zhutao198/SMU/产品需求文档PRD.md

# SMU 源表产品需求文档（PRD）

| 项 | 内容 |
|---|---|
| 产品名称 | SMU 源表（Source-Measure Unit） |
| 硬件版本 | V1（PCB `Source-measure unit -V1-240824`，BOM `BOM-SMU-V1-240904`） |
| 文档版本 | **V1.2**（V1.1 新增 Web 设置/实时显示；V1.2 记录 M1 固件框架完成及两处实现微调） |
| 日期 | 2026-10-20 |
| 状态 | M1 已实现，待评审/上电验证 |
| 依据 | 《硬件原理分析与固件设计.md》（已用 PADS 网表逐网核实）、《code/firmware/README.md》 |

---

## 1. 项目背景与目标

### 1.1 背景
硬件已完成原理图与 PCB 设计，尚未编写固件。本 PRD 在固件开发前明确产品功能、性能、接口与验收标准，作为编码与测试的唯一基准。

### 1.2 产品目标
做一台**单象限、低电流、数控电压源 + 电压/电流测量**的紧凑型源表：
- 输出 **0~30V / 0~30mA** 可编程电压或电流（CV / CC）；
- 可切换为**外部 DUT 的电压表 / 电流表**（高阻测量）；
- 通过 **USB 串口（CH340N）** 由 PC 上位机/脚本控制，无本地显示与按键；
- **内置 Web 服务器（LAN8720 以太网）**：浏览器直接访问仪器 IP 即可设置输出、实时显示测量数据与状态曲线——**网页即人机界面**，无需安装 PC 软件；
- 保留原始 TCP 命令通道作为可选调试接口。

### 1.3 非目标（明确不做）
- 负电压/负电流输出（硬件单象限，软件无法弥补）；
- 大电流（>50mA）输出——受 P2 自恢复保险丝（0.2A）与测量量程限制；
- 4 线（Kelvin）传感——本硬件为 2 线制；
- 本地人机界面（屏/按键/编码器）——硬件未提供。

---

## 2. 使用场景与用户

| 场景 | 模式 | 说明 |
|---|---|---|
| 可调电压源 | CV | 给 DUT 供 0~30V 稳定电压，带限流保护 |
| 可调电流源 | CC | 给 DUT 供 0~30mA 稳定电流（ compliance ≤30V ） |
| 电压表 | VM | 高阻测外部电压（负载 ≈96.6kΩ） |
| 电流表 | IM | 测外部灌入电流（−32mA~+32mA），内部经 Q5 接地 |
| 器件特性扫描 | CV/CC + 测量 | 扫描设定值、连续读回 V/I（软件功能） |
| 远程监控/手动操作 | Web | 任意浏览器访问仪器 IP：设置输出、看实时数据与曲线，无需 PC 软件 |

**目标用户**：实验室/产线工程师，通过 PC 上位机（后续提供）或自编脚本控制。

---

## 3. 硬件约束摘要（固件必须遵守）

| 项 | 值 | 出处 |
|---|---|---|
| MCU | STM32F407VET6，168MHz，512KB Flash | BOM |
| 输出母线 | +35V（由 +5V 经 LMR64010 升压） | 原理图 P2 |
| 功率级 | LM5106 驱动 Q3/Q4 同步降压，L3=10µH，C117/C118=10µF | 原理图 P4 |
| 占空比→电压 | **V_BUCK ≈ D × 35V** | 拓扑推算 |
| 输出开关 | Q1/Q2 串联，I_V_TEST_EN 通断（R25/D4/Q6） | 网表核实 |
| 输出保护 | P2 自恢复保险丝 0.2A（保持）/0.4A（动作） | BOM |
| 电流采样 | R133 = 1Ω，INA129 ×51，REF = 1.65V | 网表核实 |
| 电压采样 | R137 86.6k / R157 10k（÷9.66），TLV2333 缓冲 | 网表核实 |
| ADC | ADS1115，I2C 地址 0x48，16bit，PGA=±4.096V → **125µV/LSB** | 网表核实 |
| 控制脚 | VOUT_PWM=PB3(TIM2_CH2)、VOUT_EN=PB4、I_TEST_EN=PD1、I_V_TEST_EN=PD2、RDY_1=PB5、SCL=PB6、SDA=PB7 | 网表核实 |
| 输出端子 | J4：pin2=I_V_OUT，pin1=GND（2 线） | 网表核实 |
| 以太网 | LAN8720（RMII，25M 晶振，PHY 输出 50MHz → PA1；NRST 由 R4 上拉，无 GPIO 复位；PHY 地址按默认 0） | 网表核实 |
| 上位机接口 | USART1（PA9/PA10）→ CH340N → Type-C USB；以太网（Web 服务器） | 网表核实 |
| Flash 预算 | 512KB 总容量；Web 页面资源内嵌（板无外部存储），预算 **≤64KB** | 硬件推导 |
| 配置开关 | J18 两位拨码 → PC11/PC12（内部上拉，0=闭合） | 网表核实 |
| 电源链 | 9~24V → +5V → +35V → +11V；+3.3V/3.3VA；−0.23V | 网表核实 |

**已知硬件限制（影响指标，PRD 中已体现）**：
1. 电流测量量程受 VREF=1.65V 偏置影响：ADC 输入 0~3.3V 窗口 → 约 **−32mA ~ +32mA**；
2. INA129 由 +35V 供电，输出摆幅大，过流时会顶到 ADC 保护二极管（>3.3V 按饱和处理）；
3. 无 EEPROM，标定系数需自管 Flash 页；
4. Type-C 无 CC 下拉，仅 A-to-C 线可用；
5. +35V 依赖 +5V 先生成；
6. 无本地显示/LED（D10 为硬件电源指示），状态只能经通信口查询。

---

## 4. 功能需求

### 4.1 工作模式（FR-MODE）

| ID | 需求 | 验收要点 |
|---|---|---|
| FR-MODE-1 | **高阻模式（HIZ）**：输出端子与内部功率级断开，对外等效约 96.6kΩ∥(INA 输入) | 端子电压不随内部状态变化；静态电流 <10µA |
| FR-MODE-2 | **恒压输出（CV）**：闭环调节 PWM 占空比，使端子电压 = 设定值 | 见 §5 精度指标 |
| FR-MODE-3 | **恒流输出（CC）**：闭环调节占空比，使回路电流 = 设定值，电压不超过限值 | compliance ≤30V |
| FR-MODE-4 | **电压测量（VM）**：输出断开，测 DUT 端压 | 量程/分辨率见 §5 |
| FR-MODE-5 | **电流测量（IM）**：输出断开，Q5 导通将 DUT 电流引入采样电阻 | 双向，软件判符号 |
| FR-MODE-6 | 模式切换必须按安全时序执行，禁止带电直接切换（见 FR-SAFE-3） | 模式切换无输出冲击（示波器监视 <50mV 反冲） |
| FR-MODE-7 | 模式状态持久：掉电后重新上电默认进入 HIZ | 任何掉电重启均不直接输出 |

### 4.2 输出控制（FR-OUT）

| ID | 需求 |
|---|---|
| FR-OUT-1 | 电压设定范围 0~30.0V，最小设定步进 1mV，分辨率 1mV |
| FR-OUT-2 | 电流设定范围 0~30.0mA，最小设定步进 0.01mA，分辨率 10µA |
| FR-OUT-3 | CV 模式下限流：回路电流超过 `CURR` 设定值时自动进入限流（不损坏硬件，指标降级允许） |
| FR-OUT-4 | CC 模式限压：端子电压超过 `VOLT:PROT` 设定值时立即关断输出并置保护标志 |
| FR-OUT-5 | 输出软启动：从 0 到设定值的建立过程单调、无过冲 >2%，建立时间 <500ms（0→30V 阶跃） |
| FR-OUT-6 | 设定值在输出中可实时修改，修改后 200ms 内收敛到新值 ±1% |

### 4.3 测量（FR-MEAS）

| ID | 需求 |
|---|---|
| FR-MEAS-1 | 电压测量量程 0~30V，分辨率 1.2mV，刷新率 ≥100 次/s |
| FR-MEAS-2 | 电流测量量程 −32mA~+32mA，分辨率 2.5µA，刷新率 ≥100 次/s |
| FR-MEAS-3 | 采样由 ADS1115 的 ALERT/RDY（→PB5）中断驱动，禁止固定延时轮询 |
| FR-MEAS-4 | 软件数字滤波（滑动平均/中值，窗口可配置，默认 8 点），滤除 PWM 斩波纹波 |
| FR-MEAS-5 | 原始 ADC 码值、工程量、滤波后工程量均可查询（调试用） |
| FR-MEAS-6 | 标定：电压/电流各支持两点（零点+增益）标定，系数存 Flash，支持恢复出厂默认 |

### 4.4 通信接口（FR-COMM）

| ID | 需求 |
|---|---|
| FR-COMM-1 | USART1：115200-8N1，ASCII 命令，LF 结尾，单行单命令；命令回显错误信息 |
| FR-COMM-2 | SCPI 风格命令子集（§6），查询以 `?` 结尾，响应一行 ASCII |
| FR-COMM-3 | 通信看门狗：输出模式下 5s 无有效命令 → 按配置（默认保持，可配关断）处理 |
| FR-COMM-4 | 错误队列：错误码 + 文本，支持 `SYST:ERR?` 读取与清除 |
| FR-COMM-5 | ~~二期~~：以太网**原始 TCP 命令通道**（端口 5025）降级为**可选调试接口**，命令层复用 §6.2，不阻塞 V1.0 验收（Web 通道见 §4.6） |
| FR-COMM-6 | J18 拨码状态可查询；其功能用途预留（建议：bit0=默认 CV/CC 上电模式，bit1=保留），最终定义见评审结论 |

### 4.5 自检与诊断（FR-DIAG）

| ID | 需求 |
|---|---|
| FR-DIAG-1 | 上电自检：I2C 总线扫描（ADS1115 @0x48 必须在线）、ADC 读写校验、Flash 标定区 CRC 校验 |
| FR-DIAG-2 | 自检失败 → 进入 HIZ 并上报错误码，禁止输出 |
| FR-DIAG-3 | 运行中 ADC 通信失败/数据异常（连续 N 次超范围）→ 关断输出并置错误 |
| FR-DIAG-4 | MCU 片内温度传感器周期读取，可用于过温预警（非精确保护） |
| FR-DIAG-5 | `STAT?` 返回状态字：模式 / 就绪 / 保护触发 / ADC 在线 / 错误码 |

### 4.6 Web 界面（FR-WEB）★本次新增

> 定位：**网页即人机界面**。仪器接入以太网后，任意浏览器（PC/手机）打开仪器 IP 即可完成全部设置与监控，
> 不需要安装 PC 端软件。Web 与串口共用同一命令层与状态机，**不是旁路**。

| ID | 需求 | 验收要点 |
|---|---|---|
| FR-WEB-1 | 以太网基础：LAN8720 RMII，**FreeRTOS + LwIP**；上电自动初始化；IP 获取 **DHCP 优先，失败回退静态 192.168.1.10/24**（可改，存 Flash）；当前 IP 在上电时经串口打印、并在页面显示 | 网线插入后 PC 能 ping 通仪器 |
| FR-WEB-2 | HTTP 服务：端口 80；页面资源（HTML/CSS/JS）**内嵌于固件 Flash**（LwIP `fs`，构建脚本由源码生成 C 数组），禁止依赖外部文件系统；单页应用，总资源 **≤64KB** | 构建时检查大小；无外挂 CDN/字体/图片请求 |
| FR-WEB-3 | 页面显示（中文 UI，UTF-8，响应式可窄栏）：当前模式、V/I 设定值、**V/I 实时测量值**、保护阈值、状态字与错误信息、J18 拨码状态、固件版本、仪器 IP 与 MAC | 数据与串口 `MEAS:ALL?`/`STAT?` 一致 |
| FR-WEB-4 | 页面操作：模式切换（CV/CC/VM/IM/HIZ）、电压/电流设定、保护阈值设置、OUTP ON/OFF、`*RST`/`*CLS`；参数范围校验与串口完全一致，非法输入返回错误提示 | 所有操作与串口等效 |
| FR-WEB-5 | **实时刷新**：测量数据 **≤500ms** 自动刷新、无整页重载（AJAX 轮询 `/data.json`，间隔 300ms）；页面带 **V/I 滚动曲线**（Canvas 手绘，本地 60 点缓冲，禁用第三方库） | 曲线连续无卡顿；刷新不影响控制环（见 AC-12） |
| FR-WEB-6 | 安全一致性：Web 命令与串口命令走**同一状态机**，§7 的 SR-1~SR-7 全部适用；Web 不能绕过任何保护与互锁；模式切换时序强制 | 通过网页触发保护，行为与串口一致 |
| FR-WEB-7 | 并发控制：串口与 Web 可同时在线；命令层串行化（命令队列），**后写覆盖**；两个通道不得并发发起模式切换（队列 + 状态机天然串行） | 双通道同时操作不死锁、不抖动 |
| FR-WEB-8 | 网络健壮性：网线热插拔、DHCP 租约更新、异常断开均不得影响控制环（tcpip/httpd 任务优先级**低于**控制任务）；同时活跃连接 ≤4 | 拔插网线时输出不中断（控制环照常） |
| FR-WEB-9 | V1.0 **无认证**（适用隔离实验网），风险登记 R-11；预留后续加 token 的结构 | 文档明示风险 |

---

## 5. 性能指标（PR）

> 受硬件 1% 采样电阻/分压电阻、INA129 增益误差、ADS1115 内部基准限制，**未标定前的典型精度约 ±2%**；
> 标定后目标如下（验收时以 4½ 位标准源表比对）。

| ID | 指标 | 目标值 | 备注 |
|---|---|---|---|
| PR-1 | 电压设定准确度（标定后） | ±(0.5% + 2mV) | 25℃ |
| PR-2 | 电压测量准确度（标定后） | ±(0.5% + 2mV) | 分压比 9.66 |
| PR-3 | 电流设定/测量准确度（标定后） | ±(1% + 10µA) | shunt 1% → 需标定补偿 |
| PR-4 | 电压分辨率 | 1.2mV | 125µV × 9.66 |
| PR-5 | 电流分辨率 | 2.5µA | 125µV / 51 |
| PR-6 | 输出建立时间 | <500ms（0→30V，空载） | 软启动 |
| PR-7 | 24h 稳定性 | 电压 <±10mV；电流 <±20µA | 25℃ 恒温 |
| PR-8 | 控制环更新率 | ≥100Hz | RDY 中断驱动，330SPS ADC |
| PR-9 | 上电到就绪时间 | <2s | 含自检 |
| PR-10 | 静态功耗（输出关断） | <1W | 整机 |

---

## 6. 通信协议需求（IR）

### 6.1 物理层
USART1 115200-8N1，无硬件流控。命令行以 LF（`\n`）结束，最长 64 字符；大小写不敏感；命令与参数间空格或逗号分隔。

### 6.2 命令集（V1.0 必须实现）

| 命令 | 类型 | 说明 / 响应示例 |
|---|---|---|
| `*IDN?` | 查询 | `SMU-V1, FW1.0.0, SN:xxxxxxxx` |
| `*RST` | 执行 | 复位到上电默认（HIZ、设定值 0、保护默认） |
| `*CLS` | 执行 | 清错误队列与保护标志 |
| `MODE?` | 查询 | `CV` / `CC` / `VM` / `IM` / `HIZ` |
| `MODE CV\|CC\|VM\|IM\|HIZ` | 执行 | 按安全时序切换，失败返回错误 |
| `VOLT?` / `VOLT <v>` | 查询/执行 | 电压设定值，单位 V，范围 0~30 |
| `CURR?` / `CURR <i>` | 查询/执行 | 电流设定值，单位 mA，范围 0~30 |
| `VOLT:PROT?` / `VOLT:PROT <v>` | 查询/执行 | 过压保护阈值，默认 30V |
| `CURR:PROT?` / `CURR:PROT <i>` | 查询/执行 | 过流保护阈值，默认 30mA |
| `OUTP ON\|OFF` | 执行 | ON = 进入当前设定模式输出；OFF = HIZ |
| `MEAS:VOLT?` | 查询 | 端子电压工程量，如 `12.3456`（V） |
| `MEAS:CURR?` | 查询 | 回路电流工程量，如 `10.1234`（mA） |
| `MEAS:ALL?` | 查询 | `V=12.3456,I=10.1234` |
| `STAT?` | 查询 | 状态字（位域，见下），如 `13` |
| `SYST:ERR?` | 查询 | 错误码 + 文本；队列空返回 `0,"No error"` |
| `SYST:VERS?` | 查询 | 固件版本 |
| `CAL:VOLT:ZERO` / `CAL:VOLT:GAIN <v>` | 执行 | 两点标定（外部标准源接入时执行） |
| `CAL:CURR:ZERO` / `CAL:CURR:GAIN <i>` | 执行 | 同上 |
| `CAL:SAVE` / `CAL:DEF` | 执行 | 保存系数到 Flash / 恢复默认 |
| `J18?` | 查询 | `0`/`1`/`2`/`3`（两位拨码） |
| `RAW?` | 查询 | 原始 ADC 码值（调试）：`AIN0=xxxx,AIN1=xxxx,AIN2=xxxx,AIN3=xxxx` |

错误响应格式：`-100,"Command error"`（SCPI 风格负错误码）。

**状态字（`STAT?` / `stat` 字段）位域定义**（Web 页面与串口共用）：

| bit | 值 | 含义 |
|---|---|---|
| 0 | 1 | READY 就绪（自检通过） |
| 1 | 2 | PROT 保护锁存（过压/过流/ADC 失效，需 `*CLS` 解除） |
| 2 | 4 | ADC_OK ADS1115 在线 |
| 3 | 8 | OUT_ACTIVE 输出已建立 |

示例：`13` = READY + ADC_OK + OUT_ACTIVE。

### 6.3 Web 接口规格（V1.0 范围，FR-WEB）

所有端点返回 UTF-8 文本/JSON；`/set` 参数校验、量程、保护规则与 §6.2 串口命令完全一致。

| 端点 | 方法 | 说明 |
|---|---|---|
| `/` | GET | 单页应用（HTML+CSS+JS 全部内嵌，见 FR-WEB-2） |
| `/data.json` | GET | 实时数据快照，示例：<br>`{"mode":"CV","vset":12.0,"iset":10.0,"vmeas":12.003,"imeas":9.998,"vprot":30,"iprot":30,"outp":1,"stat":13,"err":0,"j18":0,"fw":"1.0.0","ip":"192.168.1.10","mac":"00:80:e1:12:34:56"}` |
| `/set` | GET/POST | 表单参数：`mode=CV\|CC\|VM\|IM\|HIZ`、`volt=<0~30>`、`curr=<0~30>`、`vprot=<5~30>`、`iprot=<1~30>`、`outp=0\|1`；成功返回 `OK`，失败返回 `-1xx,"错误描述"` |
| `/cmd` | POST | 透传一条 §6.2 串口命令（调试用，如 `*IDN?`），响应同串口 |

- 刷新策略：页面每 **300ms** 轮询 `/data.json`；曲线数据用页面本地缓冲（60 点 ≈ 18s 窗口），不占用仪器存储。
- 静态资源策略：全部内嵌，无 Cookie、无外部依赖；页面在 Chrome/Edge/Firefox 当前两个大版本实测通过。
- 原始 TCP SCPI 通道（端口 5025）：**可选**，不阻塞 V1.0 验收。
- **原型已就绪**：`code/web/src/index.html`（19.3KB，单文件、零外部依赖）。浏览器直接打开即可评审；
  后端不可达时自动进入"演示模式"（本地仿真 CV/CC/VM/IM/HIZ、保护锁存、`*CLS`/`*RST`），
  固件接线后页面自动切换为真实端点，**无需任何改动**。

---

## 7. 安全与保护需求（SR）

| ID | 需求 | 实现要点 |
|---|---|---|
| SR-1 | **上电安全态**：任何复位/异常路径下默认 HIZ，输出只在收到明确命令后建立 | 初始化序列末尾才允许 `OUTP ON` |
| SR-2 | **过压保护**：`VOLT:PROT` 阈值（默认 30V）触发 → 100ms 内关断（VOUT_EN=0 + I_V_TEST_EN=1 + 占空比清 0），锁存，需 `*CLS` 或 `*RST` 解除 | 母线 35V，留 5V 裕量 |
| SR-3 | **过流保护**：`CURR:PROT` 阈值（默认 30mA）触发 → 同上；P2 保险丝（0.4A 动作）为最后硬件兜底 | 触发后报告 `ERR 1201` |
| SR-4 | **模式切换互锁**：输出模式↔测量模式必须先 HIZ 过渡（先 VOUT_EN=0 → 20ms → I_V_TEST_EN=1 → 按需 I_TEST_EN），禁止 I_V_TEST_EN 与 VOUT_EN 同时为有效输出组合 | 状态机强制 |
| SR-5 | **ADC 失效保护**：I2C 超时/数据异常 → 关断输出，锁存 | FR-DIAG-3 |
| SR-6 | **看门狗**：IWDG 100ms，喂狗失败自动复位（复位后仍为 HIZ） | 防飞控 |
| SR-7 | **反接/过流硬件**：输入端 D1（SS34）+ 输出端 P2 保险丝为硬件级，软件只做状态记录，不做依赖 | — |

---

## 8. 非功能需求（NFR）

| ID | 需求 |
|---|---|
| NFR-1 | **可标定性**：所有模拟链路系数（分压比、INA 增益、VREF、ADC 基准）以浮点系数集中管理，支持在线标定与 Flash 持久化 |
| NFR-2 | **Flash 磨损**：标定区采用双备份 + CRC + 写入计数，寿命 ≥10 万次保存；运行中禁止频繁写 Flash |
| NFR-3 | **可测试性**：提供 `RAW?`、`STAT?`、`SYST:ERR?`；关键中间量（占空比、滤波值、误差积分项）可在调试编译期打开 |
| NFR-4 | **代码结构**：**FreeRTOS + LwIP（netconn API）**；驱动（GPIO/PWM/I2C/ADS1115/Ethernet）与应用（模式状态机/控制环/命令层/Web）分层；HAL/LL；应用层禁止直接操作寄存器 |
| NFR-5 | **可维护性**：每处硬件假设（量程、引脚、时序）在代码中以宏/注释引用本文档章节号 |
| NFR-6 | **开发环境**：STM32CubeMX + HAL（或 LL）+ FreeRTOS + LwIP，Keil/IAR/GCC 任一；固件版本号统一在 `version.h` |
| NFR-7 | **文档**：随代码提交《固件设计说明》与《标定操作指南》，与本文档需求 ID 对应 |
| NFR-8 | **Web 资源构建**：页面源码独立存放（`code/web/src`），由构建脚本转为 C 数组（`fsdata.c`）随固件编译；总大小 ≤64KB（FR-WEB-2），超限构建失败 |

---

## 9. 验收标准（AC）

| ID | 验收项 | 方法 | 通过标准 |
|---|---|---|---|
| AC-1 | 模式全覆盖 | 串口命令遍历 5 种模式，万用表/示波器监视端子 | 5 模式行为符合 §4.1，切换无反冲 |
| AC-2 | CV 精度 | 0/5/10/15/20/25/30V 六点，标准源表比对 | 满足 PR-1 |
| AC-3 | CC 精度 | 1/5/10/20/30mA 五点（电阻负载） | 满足 PR-3 |
| AC-4 | VM/IM 精度 | 外部标准源输出 0~30V / 0~30mA，本机测量 | 满足 PR-2/PR-3 |
| AC-5 | 建立时间 | 0→30V 阶跃，示波器 | <500ms，过冲 <2% |
| AC-6 | 保护功能 | 分别触发过压/过流/ADC 失效/看门狗 | 100ms 内安全关断，状态可读，可恢复 |
| AC-7 | 通信健壮性 | 错误命令/超时/乱序/大小写 | 有错误响应，不死机；看门狗按配置动作 |
| AC-8 | 掉电重启 | 反复上电 50 次 | 每次均 HIZ 起步，无意外输出 |
| AC-9 | 老化 | 输出模式连续运行 72h | 无死机、无保护误触发，PR-7 漂移达标 |
| AC-10 | 标定流程 | 按《标定操作指南》执行两点标定 | 标定后达到 PR-1~PR-3；`CAL:DEF` 可回退 |
| AC-11 | **Web 功能** | 浏览器访问仪器 IP：读实时数据与曲线、改设定值、切模式、触发保护 | 数据 ≤500ms 刷新；操作与串口等效；SR-1~7 在 Web 路径全部生效 |
| AC-12 | **网络压力** | Web 连续轮询（300ms）同时运行 CV/CC 控制环 | 控制环频率下降 <10%；无死机、无丢命令 |
| AC-13 | **网络插拔** | 输出运行中反复插拔网线 20 次 | 输出不中断、控制环不受影响；IP 变化后页面自动恢复 |

---

## 10. 约束与假设

1. PC 端专用软件/脚本不在本 PRD 范围（Web 页面已覆盖基本操作）；串口命令集仍作为脚本化/自动化接口保留。
2. 以太网为 V1.0 范围（Web 界面）；PHY 无 GPIO 复位依赖（硬件 R4 上拉），仅需软件初始化 LAN8720。
3. 标定需要外部标准源表，由使用方在产线/实验室完成；固件提供标定通道。
4. J18 的功能定义（§4.4 FR-COMM-6）需评审确认，未确认前仅实现状态读取。
5. PCB 上 J34（SWD）若未贴片，首次烧录需飞线或后焊；`code/` 首次下载方式需与硬件方确认。
6. 电流测量范围的不对称性（−32mA~+32mA）为硬件固有，不通过软件"修复"，仅在文档与页面中明示。
7. **Web 页面资源内嵌固件 Flash**（板无外部存储），页面须精简；源码与生成物分离管理（NFR-8）。
8. 仪器 IP 默认 DHCP，失败回退 192.168.1.10/24；PC 需与仪器同网段（直连或经交换机/路由器）。
9. LAN8720 的 PHY 地址按上电默认 **0** 实现（MDIO 可改），首次联网需实测确认；若非 0 需在驱动中配置（R-10）。
10. V1.0 Web **无认证**，仅适用隔离实验网；接入办公网前须评估（R-11）。
11. 以太网为附加通道：USB 串口始终可用，Web 故障不影响仪器基本功能（降级可用）。

---

## 11. 风险与开放问题

| ID | 风险/问题 | 影响 | 对策 |
|---|---|---|---|
| R-1 | 电流量程小且不对称 | 应用场景受限 | PRD 明确量程；需求侧确认是否满足用途 |
| R-2 | P2 保险丝动作后自恢复需数秒~数十秒 | CC 误触发后长时间不可用 | 保护阈值默认 30mA，远离 0.4A 动作点 |
| R-3 | INA129 由 +35V 供电，严重过流时输出可远超 ADC 量程 | ADC 输入经 1kΩ 限流，有击穿风险 | 软件判饱和（>3.3V）立即降占空比；阈值远低于动作点 |
| R-4 | 无 EEPROM | 标定系数掉电丢失风险 | NFR-2 双备份 + CRC；出厂前执行 `CAL:SAVE` |
| R-5 | 2 线测量，线阻引入误差 | 长线大电流时压降明显 | 30mA 下线阻影响小（<30mV@1Ω）；需精确场合建议缩短线长 |
| R-6 | Type-C 无 CC 下拉 | C-to-C 线不可用 | 随产品配 A-to-C 线；文档明示 |
| R-7 | +35V 依赖 +5V | 5V 故障时全链失效 | FR-DIAG-1 上电自检间接发现；SR-5 兜底 |
| R-8 | 无本地显示 | 调试与现场诊断不便 | 串口状态查询 + `RAW?`；**Web 页面即远程界面**；后续可评估无线透传模组（硬件改版） |
| R-9 | Web 资源超出 Flash 预算 | 页面过大固件放不下 | 单页 ≤64KB 硬约束（NFR-8）；构建脚本强制检查 |
| R-10 | LwIP+FreeRTOS 集成风险（RMII 时序/PHY 地址/DHCP 环境） | 以太网不通 | M1 先做 ping 通再谈页面；PHY 地址实测；静态 IP 回退 |
| R-11 | Web 无认证，实验网内任意主机可操作仪器 | 误操作/安全 | 文档明示；二期加 token；建议隔离网使用 |
| R-12 | 双通道（串口+Web）并发写 | 设定值抖动/竞态 | 命令层串行化 + 后写覆盖（FR-WEB-7） |
| O-1 | J18 用途未定义 | 功能缺口 | 评审定义 |
| O-2 | PWM 频率未定（建议 100~200kHz） | 影响纹波/EMC/环带宽 | 开发阶段实测确定，记录到固件设计说明 |
| O-3 | LAN8720 数据手册已不在 datasheet 目录，PHY 地址/寄存器细节待查 | MDIO 访问可能失败 | 以 CubeMX LAN8720 模板默认地址 0 实现；首次联网实测 PHY ID |

---

## 12. 里程碑建议

| 阶段 | 内容 | 出口准则 |
|---|---|---|
| M1 固件框架 ✅ | FreeRTOS + LwIP 骨架、时钟/GPIO/PWM/I2C/ADS1115 驱动、串口命令解析、5 模式状态机、上电自检、Web 服务雏形、一键构建脚本 | **已完成**：编译链接通过（Flash 113KB/512KB、RAM 71KB/128KB），命令层/模式机/Web 路由全部就位；待上电验证 |
| M2 闭环与保护 | CV/CC PI 控制整定、软启动、SR-1~SR-7 完善、数字滤波 | AC-1/5/6/8 通过 |
| M3 标定与优化 | 两点标定流程验证、Flash 存储、精度优化、片内温度监控 | AC-2/3/4/9/10 通过 |
| M4 Web 界面 | `/data.json` 实时接口、单页应用（设置 + 实时值 + 曲线）接线联调 | AC-11/12/13 通过 |
| M5 交付 | 固件设计说明、标定指南、版本封板 | AC 全项通过 |
| M6（可选） | 原始 TCP SCPI 通道（5025）、批量扫描、DHCP、Web 认证 | 另行评审 |

### 12.1 M1 实现微调（相对本文档 V1.1 的偏差，已实现）

1. **RTOS 用原生 FreeRTOS API**（非 CMSIS-RTOS2）：本机 FreeRTOS 中间件的 CMSIS-RTOS v1 包装不完整，
   原生 API 更可控；`main.c` 调 `vTaskStartScheduler()`。
2. **Web 用自研 netconn HTTP 服务**（非 LwIP httpd/fs）：`smu_web.c` 直管路由，页面以 C 数组内嵌
   （`smu_webpage.h` 由 `tools/web2c.py` 生成），避免 LwIP fsdata 版本差异；满足 FR-WEB-2/6/8。
3. **以太网收包为轮询**（`task_net` 5ms 调 `SMU_NetPoll`）：不依赖 ETH 中断时序，拔插网线不影响控制环（AC-13）。
4. **命令层单一入口**：Web `/set` 把参数合成为命令走 `SMU_CmdExecute`，与串口完全同路（FR-WEB-6/7）。

---

## 13. 需求追踪

| 需求域 | 对应硬件事实（出处） |
|---|---|
| FR-MODE / FR-OUT | 原理图 P4 模式真值表；LM5106 IN/EN；Q1/Q2/Q6 通断逻辑 |
| FR-MEAS | R133+INA129+R50（电流）；R137/R157/R166/U18-A+R53（电压）；ADS1115 通道分配（网表） |
| FR-COMM | CH340N(USART1 PA9/PA10) |
| FR-WEB | LAN8720 RMII（25M 晶振 → PA1 输出 50MHz、NRST 由 R4 硬件上拉）；MCU 512KB Flash（Web 资源内嵌 ≤64KB）；RMII 引脚 PC1/PA1/PA2/PA7/PC4/PC5/PB11/PB12/PB13 |
| FR-DIAG | ADS1115 ALERT/RDY→PB5；MCU 内部温度传感器 |
| SR | P1/P2 保险丝、D4 栅压钳位、D3 采样钳位、LM5106 EN |
| PR | 量化指标全部由 §3 硬件参数推导（9.66、51、125µV/LSB、35V 母线） |
