zhutao198/SMU/硬件原理分析与固件设计.md

# SMU 源表 — 硬件原理分析与固件设计指南

> 依据：`Source-measure unit -V1-240824.pdf`（5 页原理图）、`BOM-SMU-V1-240904.xls`、`datasheet/`，
> 并用 `Source-measure unit -V1-240824.txt`（PADS Logic V9.5 网表导出）对全部关键网络做了交叉核实。
> 解读时间：2026-10-17。本文档用于编码前的原理消化，固件设计以本文档为基准。

---

## 0. 一句话总结

**STM32F407VET6** 用 **PWM（TIM2_CH2）数控一个 35V 供电的同步降压电路**产生 0~30V 输出；
输出回路串 **1Ω 采样电阻 + INA129 仪表放大器（×51）**测电流，**86.6K/10K 分压 + TLV2333 缓冲**测电压，
两者统一送到 **ADS1115（16 位 I2C ADC）**；MCU 用 4 根 GPIO（VOUT_EN / I_V_TEST_EN / I_TEST_EN / RDY_1）
切换四种工作模式。**无显示屏、无按键**，人机接口是 **CH340N（USB-Type-C，USART1）** 和 **LAN8720 以太网**。

---

## 1. 系统组成总览

| 模块 | 器件 | 说明 |
|---|---|---|
| MCU | STM32F407VET6 (LQFP-100)，8MHz 晶振 | BOM 为 VET6，原理图符号标 VGT6（同封装同 Flash，以 BOM 为准） |
| 电源输入 | J3（2P 5mm 端子），9~24V | D1 (SS34) 反接保护 |
| 数字 5V / 模拟 5V | TPS54302 同步降压 (L1 10µH/3A) | +5V（数字，经 FB2）、+5VA（模拟，经 FB21） |
| 3.3V | AMS1117-3.3 (U21) | +3.3V / +3.3VA；D10 绿色 LED (R27 1K) 电源指示 |
| 35V 功率轨 | LMR64010 升压 (L2 10µH, D13 SS34, **SOT-23-5**) | 由 +5V 升压，SHDN 接 VIN 常开 |
| 11V 驱动轨 | LM317 (R21 12K / R20 1.5K) | 11.25V，专供 LM5106 栅驱动 |
| 负压轨 | LM7705 (U17) | −0.23V，保证 INA129 输出能到 0V |
| 半桥栅驱动 | LM5106 (U7) | 驱动同步降压 Q3/Q4 |
| 功率 MOSFET | FS5N10S (5N10, SOT-23) ×6 | Q1~Q4 + Q17/Q18（原理图标 Q5/Q6，见 §10） |
| 输出滤波电感 | L3 (SWPA4030S, 10µH/1.5A) | 降压输出电感 |
| 电流采样 | R133 = 1Ω / 1% / 2512 | 输出回路 shunt |
| 电流放大 | INA129 (U19)，RG = R50 = 1K | 增益 = 1+50K/1K = **51** |
| 电压分压 | R137 = 86.6K / R157 = 10K | 比值 = 96.6/10 = **9.66** |
| 缓冲/基准 | TLV2333 (U18，符号类型 OPA2192) 双运放，供电 **V+=+5V / V−=−0.23V** | U18-A 缓冲电压采样；U18-B 产生 VREF |
| ADC | ADS1115 (U6, MSOP-10) | 16 位 I2C，ADDR=GND → 地址 **0x48** |
| USB 串口 | CH340N (U5) + Type-C (J5) | D5/D6 (KPESD5V0L) ESD 保护 |
| 以太网 | LAN8720 (U2) + HR641680E 网络变压器 | RMII，25MHz 晶振 Y1 |
| 输出端子 | J4（2P 5mm 端子） | pin2 = I_V_OUT，pin1 = GND |
| 用户开关 | J18（2 位拨码，公共端接地） | → PC11 (pin79) / PC12 (pin80) |

---

## 2. 电源架构（原理图第 2 页，已用网表+数据手册核实）

```
J3 (9~24V) ──D1(SS34 反接保护)── TPS54302(U12) ──L1 10µH──┬── FB2 ──► +5V   (数字)
   C27 10µF / C38 0.1µF        (SOT23-6，R128/R108 设 EN 门限) └── FB21 ─► +5VA  (模拟)
                                    输出侧 C40/C48 22µF

+5V ──► LMR64010(U29) 升压 ──L2 10µH, D13(SS34)──► +35V   ★注意：升压输入是 +5V，不是 9~24V！
         反馈 R43(274K)+R132(10K)，VFB=1.23V（数据手册核实）→ 1.23×284/10 = 34.9V
         输出 C69/C91 10µF + C97 18pF，经 FB17 → +35V 母线(C25/C41/C51/C95)

+5V ── AMS1117-3.3(U21) ──► +3.3V / +3.3VA (C70/C71/C72)；D10 LED + R27 1K 电源指示
+5V ── LM7705(U17) ────────► −0.23V (C134/C137/C138 去耦)，INA129 负电源轨
+35V ── LM317(U32) ────────► +11.25V (R21 12K / R20 1.5K)，LM5106 VDD + 自举(D18/C113)
```

- +5V 反馈是**三级分压** R38(10K)+R39(100K)+R42(15K)：V_FB = 0.596×125/15 ≈ **4.97V**（TPS54302 数据手册 VFB=0.596V，图上标注 Vref=0.6 正确）。
- 电源链：**9~24V → 降压 → +5V → 升压 → +35V**（35V 轨依赖 5V 轨先正常工作）。
- 固件可监控 +5V/+3.3V（ADC 富余通道，可选）。

---

## 3. SMU 功率级（原理图第 4 页）—— 本项目核心

### 3.1 数控同步降压（"电压输出"的执行机构）

```
+35V(node X, C115+C119 10µF)
   │
  Q3 (高边 NMOS，栅极 ← LM5106 HO，经 R63 33Ω，D2 为加速关断二极管)
   │
  node W ──── L3 (10µH) ──── node Y (V_BUCK, C117+C118 10µF)
   │                              │
  Q4 (低边 NMOS，栅极 ← LM5106 LO，经 R64 33Ω，D16 加速关断)
   │                              │
  GND                            Q1.D
```

- **LM5106 (U7)**：VDD=+11V；HB/HS 自举（D18 1N5819W + C113 100nF/250V）；RDT=R144 5.1k 设死区；
  - `IN (pin8)` ← **VOUT_PWM**（MCU 的 TIM2_CH2，经 R143 33Ω）→ 决定占空比；
  - `EN (pin7)` ← **VOUT_EN**（MCU GPIO，经 R138 33Ω）→ 高电平使能整个降压级。
- 理想关系：**V_BUCK ≈ D × 35V**（D 为 PWM 占空比）。要输出 30V，D≈85.7%。

### 3.2 输出通断开关（Q1/Q2 串联 + 稳压管钳位栅压）

```
node Y (V_BUCK) ──► Q1 ──► SW' ──► Q2 ──► P2(PPTC 0.2A) ──► I_T_P ──R133(1Ω)──► I_V_OUT ──► J4 (输出端子)
                          ▲                                   │
                    栅极共节点 N ◄── D4 (BZT52C10, 10V 稳压管，阴极接 SW')
                          ▲                                   │
              R25 (100K) ─┘ (来自 +35V，导通时拉高栅极)      Q5 ── P1(PPTC 0.2A) ──► GND
                          │
              Q6 (S→GND，G ← I_V_TEST_EN 经 R164 10K)
```

- Q1、Q2 **栅极并接在节点 N**（网表确认 Q1.1/Q2.1/R25.1/D4.2 同网）：
  - **I_V_TEST_EN=0** → Q6 截止 → R25 把栅极拉向 +35V，D4 把 Vgs 钳在 ≈10V → **Q1/Q2 导通**，V_BUCK 接到输出端子；
  - **I_V_TEST_EN=1** → Q6 导通 → 栅极被拉低 → **Q1/Q2 截止**，输出端子与内部功率级断开（高阻）。
- 两管串联的目的：体二极管反向串联，阻止 DUT 电流倒灌；并分摊耐压。
- **P2（自恢复保险丝 0.2A）串在输出主回路**（Q2.D → P2 → I_T_P）→ 输出电流超过约 0.4A 时断电保护，冷却后自恢复。
- Q5：**I_TEST_EN=1** 时导通，把 I_T_P 接地 → 构成"电流沉"，用于**测流模式**下把 DUT 的电流引到 shunt 上。
- Q5/Q6 的栅极网络（网表确认）：I_TEST_EN 经 R156(33Ω) → Q5 栅极，**R168(10K) 为栅极下拉**；I_V_TEST_EN 经 R165(33Ω) → Q6 栅极，**R164(10K) 为栅极下拉**。MCU 引脚浮空时默认关断。

### 3.3 模式真值表（原理图原表）

| I_V_TEST_EN | I_TEST_EN | VOUT_EN | VOUT_PWM | 功能 |
|---|---|---|---|---|
| 0 | Any | 0 | Any | 高阻态（降压关断，输出浮空） |
| 0 | Any | 1 | PWM | **可调电压/电流输出**（CV 或 CC，由软件闭环决定） |
| 1 | 0 | Any | Any | **电压测量**（输出断开，测 DUT 端压） |
| 1 | 1 | Any | Any | **电流测量**（输出断开，Q5 把 DUT 电流沉到地） |

> 说明：硬件只能"source"（0~+30V）；"电流输出"= 软件用 I_V_AD 做闭环调占空比实现恒流（CC）。
> 测流模式下 DUT 电流路径：I_V_OUT → R133 → I_T_P → Q5 → P1 → GND，Q5 的 Rds_on（欧级）会串入，
> 且总电流受 P1/P2（0.2A）限制。

---

## 4. 测量链路（原理图第 4 页）

### 4.1 电压测量（2 线，测输出端子电压）

```
I_V_OUT ──R137 86.6K──┬── V_TEST ──C23(18pF)──GND
                       │
                    R157 10K ── GND        （分压比 96.6/10 = 9.66）
                       │
                    R166 10K ──► U18-A (TLV2333 电压跟随器) ──► V_TEST_AD ──R53(1K)──► ADS1115 AIN0
```
- D3 (BAV99 双二极管) 组成钳位（网表：D3.1→GND，D3.2→+5VA，D3.3→V_TEST）：V_TEST 被限幅在 −0.7V ~ +5.7V，保护 ADC/运放输入。钳位支路**无串接保险丝**，持续过压可能损坏 D3。
- 图上标注：**V_TEST 电压 0~3.11V ↔ 输入 0~30V**。

### 4.2 电流测量

```
R133 (1Ω) 两端 ──R48/R49 (各10K)──► INA129 (U19)
INA129: 增益 G = 1 + 50K/R50 = 1 + 50K/1K = 51
        REF (pin5) ← VREF (1.65V)；+VS ← +35V(经 FB3/C39/C2 滤波)；−VS ← −0.23V
输出 Vo = (V+ − V−) × 51 + VREF      （原理图原标注公式）
        ──► I_V_AD ──R58(1K)──► ADS1115 AIN2
```
- R133 在输出主回路上，Q1/Q2 导通时测的是**输出电流**；Q5 导通时测的是 **DUT 灌入的电流**（方向由 ±IN 接法决定，软件判符号）。
- 注意：INA129 由 **+35V** 供电（不是 +11V），输出摆幅大；ADS1115 输入靠 R58(1K) 限流 + 自身 ESD 二极管保护，I_V_AD > 3.3V 应按饱和处理。

### 4.3 参考源 VREF

```
+3.3VA ──R46 10K──┬──(U18-B +IN)   U18-B (TLV2333/BOM型号，R40 10K 电压跟随) ──► VREF ≈ 1.65V
                  │
               R41 10K ── GND
```
- U18 供电（用户确认，原图已接）：**V+(pin8) → +5V，V−(pin4) → −0.23V**（总电源 5.23V）。
  双 5V 供电给 0~3.11V 的信号留足了输出摆幅余量，比 3.3V 供电更合理。
- VREF = 3.3 × 10/(10+10) = **1.65V**，送 INA129 的 REF 引脚（给电流信号加中偏置），并经 R56/R57(1K) 送 ADS1115 AIN1/AIN3 供软件校准/基准监视。

---

## 5. ADC：ADS1115 (U6)

| 项 | 值 |
|---|---|
| 接口 | I2C1：SCL=**PB6**，SDA=**PB7**，板上 R51/R52 10K 上拉 |
| 地址 | ADDR 接地 → **0x48** |
| 数据就绪 | ALERT/RDY (pin2) → **PB5 (RDY_1)**，可做外部中断 |
| **AIN0** | **V_TEST_AD（电压）**，经 R53(1K) |
| AIN1 | VREF（基准），经 R56(1K) |
| **AIN2** | **I_V_AD（电流）**，经 R58(1K) |
| AIN3 | VREF（基准），经 R57(1K) |
| 推荐 PGA | ±4.096V（默认），单端 0~4.096V，16bit → **125µV/LSB** |

> 通道分配已用 PADS 网表核实：AIN0=电压、AIN2=电流、AIN1/AIN3=参考。
> AIN1/AIN3 都接 VREF 可用来监视基准/做比率测量，软件可选用。

---

## 6. MCU 引脚分配（已逐根确认）

| 信号 | STM32 引脚 | 方向 | 去向 / 说明 |
|---|---|---|---|
| VOUT_PWM | **PB3** (pin89) | 输出(AF) | TIM2_CH2（需 AFIO 部分重映射到 PB3）→ R143 → LM5106 IN |
| VOUT_EN | **PB4** (pin90) | 输出 | → R138 → LM5106 EN（高有效） |
| I_TEST_EN | **PD1** (pin82) | 输出 | → R156 33Ω → Q5 栅极（R168 10K 下拉到 GND） |
| I_V_TEST_EN | **PD2** (pin83) | 输出 | → R165 33Ω → Q6 栅极（R164 10K 下拉到 GND） |
| VREF+ (pin5) | U1.5 → VDDA | — | 用户确认原图已接（.txt 转换丢失，见 §10.1） |
| RDY_1 | **PB5** (pin91) | 输入 | ADS1115 ALERT/RDY（建议配中断或查询） |
| SCL | **PB6** (pin92) | AF/OD | I2C1_SCL |
| SDA | **PB7** (pin93) | AF/OD | I2C1_SDA |
| USART1_TX | PA9 | AF | → CH340N RXD → USB |
| USART1_RX | PA10 | AF | ← CH340N TXD |
| J18-1 | **PC11** (pin79) | 输入 | 拨码开关位 1（公共端接地，用内部上拉） |
| J18-2 | **PC12** (pin80) | 输入 | 拨码开关位 2 |
| SWD | PA13/PA14 | — | 下载/调试 |
| BOOT0/BOOT1 | — | — | R11/R13 10K 下拉；J1/J2 跳线（NC）可上拉进系统 Bootloader |
| ETH | PC1~PC5,PA1,PA2,PA7,PB11~PB13 | RMII | LAN8720；PHY 的 25M 晶振输出 50MHz → PA1(ETH_REF_CLK) |

**未使用的注意点**：ETH_RST 没有接 MCU，LAN8720 的 NRST 仅由 R4(10K) 上拉 + C26 延时，无需软件复位 PHY。

---

## 7. 固件数学模型（标定基准）

```
电压:  V_OUT[V] = V_TEST_AD × (96.6 / 10) = V_TEST_AD × 9.66
电流:  I[A]     = (I_V_AD − 1.65) / 51
占空比: V_BUCK  = D × 35   →  D = V_set / 35（闭环微调）
```
| 量 | 量程 | 分辨率 |
|---|---|---|
| 电压 | 0~30V（ADC 0~3.11V） | 125µV × 9.66 ≈ **1.2mV** |
| 电流 | 约 −32mA ~ +32mA（VREF 偏置导致不对称，理论上 +48mA 到 ADC 满幅） | 125µV/51 ≈ **2.5µA** |

- ADC 输入绝对最大值 VDD+0.3V（3.6V）：I_V_AD > 3.3V 应视为过流/饱和。
- 分压电阻、shunt、INA 增益均为 1% 精度 → **软件必须标定**（板上无 EEPROM，系数可硬编码或存 Flash）。
- 电压测量为 2 线制，未补偿 shunt 压降（32mA 时仅 32mV，可忽略；大电流时需注意）。

---

## 8. 建议的固件架构（STM32F4，可用 HAL/LL 或寄存器）

```
smu_fw/
├── main.c            模式状态机 + 主循环
├── drv_gpio.c        VOUT_EN / I_TEST_EN / I_V_TEST_EN / RDY_1
├── drv_pwm.c         TIM2_CH2 (PB3, AFIO 部分重映射)，占空比 0~100%
├── drv_i2c.c         I2C1 (PB6/PB7, 100kHz/400kHz)
├── ads1115.c         通道/PGA/速率配置，单端读，RDY 中断驱动
├── measure.c         ADC→工程量换算 + 标定系数 + 软件滤波
├── control.c         CV/CC PI 闭环（占空比更新）、启动软斜坡
├── protect.c         过压/过流/ADC 失效/占空比限幅（≤30V 对应 D）
├── protocol.c        USART1 命令协议（建议 SCPI 风格子集，115200-8N1）
└── (可选) eth/       LwIP + TCP/UDP，与 protocol 共用同一命令层
```

**控制环**：ADS1115 RDY 中断 → 读 AIN0(电压)/AIN2(电流) → PI → 更新 TIM2 CCR。
PWM 频率建议 100~200kHz（L3=10µH，35V 输入，兼顾开关损耗与纹波）；
ADC 速率 330SPS 时控制环约 300Hz，带宽足够（ buck 输出有 C117/C118 20µF + 负载）。

**模式切换时序**（重要，避免冲击）：
1. 进入测量模式：先 VOUT_EN=0（关断降压）→ 延时 → I_V_TEST_EN=1（断开输出）→ 再按需 I_TEST_EN。
2. 进入输出模式：先 I_TEST_EN=0、I_V_TEST_EN=0 → 软启动占空比从 0 渐升到设定值 → 确认电压建立。
3. 急停/保护：立即 VOUT_EN=0 + I_V_TEST_EN=1，占空比清 0。

**CC（恒流）模式**：以 I_V_AD 为反馈量调占空比；注意量程仅 ~±32mA，超过后开环，需靠 P2 保险丝兜底。

---

## 9. 关键设计约束（编码前必须知道）

1. **单象限**：只能输出正电压/正电流；不能吸收电流（测流模式除外，且电流能力受 P1/P2 0.2A 限制）。
2. **输出电流能力**：受 P2 PPTC（0.2A 保持/0.4A 动作）和测流量程（±32mA）双重限制。做大电流场合需先改硬件。
3. **无 EEPROM/Flash 数据区预留**：标定系数要么硬编码，要么自己管理 Flash 页。
4. **BOM 与原理图位号不一致**：原理图 Q5/Q6 = BOM 的 Q17/Q18（同为 5N10 SOT-23）；原理图 U18-A/U18-B（双运折算两个符号）= BOM 的 U18。
5. **BOM 仪表放大器写 "INA128/IAN129"**，原理图符号与引脚（RG 脚）为 INA128/129 系列，按 INA129 用。
6. **BOM MCU 为 STM32F407VET6**，原理图符号标 VGT6（同封装同 Flash，引脚号完全一致）。
7. **ADS1115 ALERT/RDY 无外部上拉**：配置为 RDY 功能时依赖 PB5 内部上拉（建议代码里打开）。
8. **PWM 纹波会耦合进电压采样**：硬件有 C23(18pF)+U18-A 缓冲，软件再做滑动平均/中值滤波。
9. **J18 拨码开关**：接 PC11/PC12，公共端接地，= "两个用户开关"，不是 BOOT 开关。启动模式由 R11/R13 下拉 + J1/J2（NC）决定，默认从 Flash 正常启动。
10. 以太网为可选功能（PHY 无软件复位线）；建议先把 USART 命令链路 + SMU 闭环做扎实，再考虑网络。
11. **35V 轨由 +5V 升压产生**：上电时若 5V 轨异常，35V/11V/−0.23V 全都会异常，保护逻辑要把这条链考虑进去。

---

## 10. 原理图本身的问题（2026-10-19 用 PADS 网表核对时发现，需硬件方确认）

转换后的 `Source-measure unit -V1-240824.txt` 与原 PDF **连接关系一致**（逐网核对无差异、无引脚跨网短路）。
以下是原原理图自身的问题，与格式转换无关：

1. **LAN8720 的 RXER(U2.10) 悬空**：RMII 模式不用 RXER，用户确认有意悬空。
2. **U5.4（CH340N）悬空**：内部时钟方案，用户确认有意悬空。
3. **Type-C（J5）CC1/CC2/SBU（J5.3/.4/.9/.10）悬空、无 5.1K 下拉**：用户确认有意为之 → 只有 A-to-C 线能用（C-to-C 线不会供电/枚举）。VBUS(J5.2/.11) 也未使用（整机由 J3 供电，USB 只做串口）。
4. **BOM 标 NC 的 C126/J1/J2/J34/R14 在网表中实际有连接**：属于"可不采购"件，非错误；但若打算用 SWD 下载，需确认 J34 是否贴片。
5. **+35V 升压的输入是 +5V 而非 9~24V**（网表+图纸双重确认）：上电顺序上 5V 轨是 35V 轨的前提。
6. **CON1.4/.5/.12/.13、RJ1.13/.14 悬空**：网络变压器/RJ45 空脚，用户确认正常。

> 更正记录（用户确认）：
> ① U18 电源脚：**原图已接**（V+→+5V、V−→−0.23V），是 .txt 转换丢失；
> ② U1.5(VREF+)：**原图已接 VDDA**，同样是 .txt 转换丢失；
> ③ U29 第 6 脚：**不存在**——LMR64010 是 5-Lead SOT-23（数据手册 DBV0005A，Figure 1），
> 符号引脚 1=SW、2=GND、3=FB、4=SHDN、5=VIN 与手册一致；SHDN(EN) 接 +5V(=VIN) 即常开，
> 正是手册 "Connect to VIN if this feature is not used" 的推荐用法。
> ④ 其余悬空脚（RXER/U5.4/CC 脚/变压器空脚）经用户确认均为有意悬空。
> 详见 §10.1。

## 10.1 网表（.txt）与图纸/BOM 的一致性结论（2026-10-19 核对）

- **连接关系：与 PDF 一致**。逐网比对了 5 页原理图、125 个命名网络、209 个位号，无差异；无引脚跨接多个网络（无隐性短路/串页错误）；MCU 引脚号、ADC 通道、功率级拓扑全部吻合。
- **但 .txt 转换丢失了已知 5 个引脚的连接**（用户对照原图确认原图已接，.txt 中没有）：
  - `U18-A.8 / U18-B.8`（V+ → +5V）、`U18-A.4 / U18-B.4`（V− → −0.23V）
  - `U1.5`（STM32 的 VREF+ → VDDA）
  - 佐证：.txt 的 *PARTTYPE* 段中 OPA2192 明确定义了 `SIGPIN 4 VSS` / `SIGPIN 8 VCC`，符号有这两个脚，只是连接没导出来。
  - **结论：.txt 不能 100% 当网表使用**。建议从当前 .sch 重新导出后再核对；若已把 .txt 用于下游（导 PCB/仿真），需手工补回这 5 个连接。
- **器件型号属性（*PART* 里的 type 字段）有 4 处与图纸/BOM 不一致**（不影响连接，但会影响下单/贴片）：

| 位号 | 网表 type | 图纸文字 / BOM | 说明 |
|---|---|---|---|
| Y2 | 25MHZ | **8 MHz**（图1 文字 + BOM） | MCU 主晶振类型属性错，易下错料 |
| L1/L2/L3 | 15UH_4.7A | **10µH**（L1 10µH/3A、L2/L3 10µH/1.5A/4030） | 电感类型属性错 |
| U18-A/U18-B | OPA2192 | **TLV2333**（BOM） | 两者均 SOIC-8、引脚兼容（双 RRIO 运放），型号要统一 |
| U1 | STM32F407VGT6 | STM32F407**VET6**（BOM） | 同封装同 Flash，以 BOM 为准 |

- 另：网表中 **D5/D6（USB TVS）用字母脚名 D5.A/D6.K**（其他二极管用数字脚名），用脚本解析网表时容易漏掉，特此记录。
- **J18 在 PADS 中的类型名是 "BOMAKAIGUAN"（BOM 开关）**：接 PC11/PC12，带内部上拉读取，可能是区分 BOM 变体的配置位，固件可读取（0=闭合）。
