zhutao198/SMU/hardware/BOM-SMU-V1-240904.xls

BOM-SMU-V1.0
名称 | 编号 | 规格 | 封装 | 数量 | 备注
PCB |  |  |  | 1
贴片电容 | C1,C5,C6,C7,C10,C13,C18,C21,C22,C24,C29,C30,C31,C32,C33,C36,C37,C42,C43,C44,C45,C46,C47,C49,C50,C53,C58,C64,C70,C122,C124,C137,C138,C139,C141,C143 | 100nF，50V，X7R,0402 | 0402 | 36
贴片电容 | C2,C25,C38,C41,C56,C57 | 100nF，50V，X7R,0603 | 0603 | 6
贴片电容 | C3，C8，C26 | 1uF，16V，X7R,0402 | 0402 | 3
贴片电容 | C14,C15,C16,C17 | 10pF，16V，X7R,0402 | 0402 | 4
贴片电容 | C11,C12,C23,C34,C35 | 18pF，16V，X7R,0402 | 0402 | 5
贴片电容 | C97 | 18pF，50V，X7R,0603 | 0603 | 1
贴片电容 | C28 | 47pF，16V，X7R,0402 | 0402 | 1
贴片电容 | C113 | 100nF，250V，X7R,1206 | 1206 | 1
贴片电容 | C4,C9,C55 | 1000pF，1000V，X7R,1206 | 1206 | 3
贴片电容 | C19,C20,C52,C125 | 4.7uF，16V，X7R,0603 | 0603 | 4
贴片电容 | C27,C39,C51,C69,C91,C95,C115,C117,C118,C119,C142 | 10uF，50V，X7R,1206 | 1206 | 11
贴片电容 | C40,C48,C54,C68,C71,C72,C94,C134 | 22uF,10V,X7R,0805 | 0805 | 8
贴片电阻 | R133 | 1R,1%，2512 | 2512 | 1
贴片电阻 | R63,R64,R138,R143,R156,R165 | 33R,5%，0402 | 0402 | 6
贴片电阻 | R15,R16,R18,R19 | 49.9R,1%，0402 | 0402 | 5
贴片电阻 | R6,R8,R10,R12 | 75R,1%，0402 | 0402 | 4
贴片电阻 | R7,R24,R27,R50,R53,R56,R57,R58 | 1K,1%，0402 | 0402 | 8
贴片电阻 | R2,R20 | 1.5K,1%，0402 | 0402 | 2
贴片电阻 | R144 | 5.1K,1%，0402 | 0402 | 1
贴片电阻 | R5,R21 | 12K,1%，0402 | 0402 | 2
贴片电阻 | R42 | 15K,1%，0402 | 0402 | 1
贴片电阻 | R1,R3,R4,R9,R11,R13,R22,R23,R38,R40,R41,R46,R48,R49,R51,R52,R132,R157,R164,R166,R167,R168 | 10K,1%，0402 | 0402 | 22
贴片电阻 | R137 | 86.6K,1%，0402 | 0402 | 1
贴片电阻 | R25,R39,R108 | 100K,1%，0402 | 0402 | 3
贴片电阻 | R43 | 274K,1%，0402 | 0402 | 1
贴片电阻 | R128 | 510K,5%，0402 | 0402 | 1
贴片磁珠 | FB1,FB8 | 600R/100MHz，0603 | 0603 | 2 | 可以用0R电阻代替
贴片磁珠 | FB2,FB3,FB4,FB5,FB6,FB7,FB17,FB21 | 600R/100MHz，0805 | 0805 | 8
贴片无源晶振 | Y1 | 25MHz,10pF,50PPM，HC49SMT | 49S | 1
贴片无源晶振 | Y2 | 8MHz,10pF,50PPM，HC49SMT | 49S | 1
发光二极管 | D10 | 0603，绿色普亮 | 0603 | 1
TVS | D5,D6 | KPESD5V0L1BL | 0402 | 2
肖特基二极管 | D2,D16,D18 | 1N5819W，SOD-123 | SOD-123 | 3
稳压二极管 | D4 | 10V，BZT52C10,SOD-123 | SOD-123 | 1
肖特基二极管 | D3 | BAV99,SOT23 | SOT23 | 1
肖特基二极管 | D1,D13 | SS34，SMA | SMA | 2
网络变压器 | CON1 | H1102/BT16B03/HR641680E ，贴片 |  | 1
NMOS管 | Q1,Q2,Q3,Q4,Q17,Q18 | 5N10，SOT23 | SOT-23 | 6
自恢复保险 | P1,P2 | SMD0805B020TF,0805 | 0805 | 2
功率电感 | L1 | SWPA8040S，10uH | 8040 | 1
功率电感 | L2,L3 | SWPA4030S100MT，10uH | 4030 | 2
USB转UART | U5 | CH340N,SOIC-8 | SOIC-8 | 1
LDO电源芯片 | U21 | AMS1117-3.3，SOT223 | SOT-223 | 1
线性调整电源芯片 | U32 | LM317，SOT223 | SOT-223 | 1
电源芯片 | U29 | LMR64010，SOT-23-5 | SOT-23-5 | 1
电源芯片 | U17 | LM7705，VSSOP-8 | VSSOP-8 | 1
电源芯片 | U12 | TPS54302，SOT23-6 | SOT23-6 | 1
半桥驱动 | U7 | LM5106 | VSSOP-10 | 1
运放 | U18 | TLV2333，SOIC-8 | SOIC-8 | 1
仪表运放 | U19 | INA128/IAN129，SOIC-8 | SOIC-8 | 1
ADC转换芯片 | U6 | ADS1115,MSOP-10 | MSOP-10 | 1
以太网PHY | U2 | LAN8720,QFN24 | QFN24 | 1
MCU | U1 | STM32F407VET6，LQFP-100 | LQFP-100 | 1
插件
接线端子 | J3,J4 | 714X-5MMX2，5mm，2pin |  | 2
拨码开关 | J18 | 2位，2.54*7.62mm，插件 |  | 1
RJ45插座 | RJ1 | 屏蔽带灯，2.02mm间距，5.75mm，90° |  | 1
USB插座TYPE-C | J5 | TYPE-C，C393939 |  | 1
NC | R14,C126,H1,H2,H3,H4,J1,J2,J22,J23,J24,J34 |  |  | 12
