zhutao198/SMU/开发日志.md

# SMU 源表 · 开发日志

> 固件调优批次（控制环 / 测量链 / 保护），对应 PRD 里程碑 M2 收尾。
> 日期：2026-10-29。作者：AI 辅助开发。

---

## 0. 背景与结论速览

本批次解决的是 **CV/CC 闭环输出质量** 问题，按"现象 → 定位 → 修复 → 验证"推进，最终四项指标全部达标：

| 问题 | 根因 | 修复 | 结果 |
|---|---|---|---|
| 低频方波纹波（8–20ms，19–76mV） | Σ-Δ 抖动 1 码步长远超 CV 死区，被反馈环当误差反复"掰"占空比（极限环）。本质：`smu_ctrl_pick_arr` 把输出电感写死成 `10µH`，实际已换 `300µH` → `f_sw` 虚高 → 1 码步长 76mV ≫ 5mV 死区 | 电感参数改为 `300µH` + 放宽 `SMU_DI_RIPPLE_MAX`、量化档 50kHz→10kHz，使 `f_sw` 落到 ~20kHz 档，**1 码步长 ≤~4mV < 死区** | 方波消失 |
| 万用表有效值跳动（伪随机抖动版） | 伪随机化让抖动能量变成随机白噪声，环在随机噪声上乱掰 → 读数乱跳 | 回退为**确定性 Σ-Δ**（固定音调被万用表平均成稳定有效值） | 读数重新变稳 |
| 20kHz 开关纹波（12V 时 550mV p-p） | 输出端仅 `C118/C117` 两个 10µF 陶瓷（直流偏压下有效 ~7µF），扛不住 20kHz 开关纹波（ΔI≈0.5A） | **硬件补输出电容（实测 470µF 解决；建议长期 220–330µF）** | 纹波拉到 ~7–15mV |
| 稳定时间：5.5V→5V 约 3s | 软启动 300ms ramp 期间 `err>0` 把 CV 积分攒到 `INT_MAX`，ramp 结束后需数秒回卷 | **软启动期间冻结积分（anti-windup）** + `KI_CV` 0.0002→0.0006 | 峰值基本不冲高，回落缩到百毫秒级 |

> 关键经验：**伪随机抖动看似"消除方波"，实则把稳定读数搞砸**——方波的真凶是"抖动步长 > 死区"而非抖动波形，治本是让步长落进死区（降 `f_sw` 需匹配真实电感），而非打乱波形。

---

## 1. 低频方波：根因与修复（核心）

### 1.1 现象
换 300µH 输出电感后，输出端出现 8–12ms（后变宽到 20ms）的方波纹波；万用表（DC/RMS）在确定性抖动版读数很稳，伪随机版则乱跳。

### 1.2 定位
`SMU_CtrlSetDuty` 用一阶 Σ-Δ 抖动：`s_dither_acc` 周期溢出 → PWM 比较值在相邻两码间按 `frac×250Hz` **固定频率**切换 → 25–125Hz 二电平方波直接打在输出。
- `SMU_TIM_CLK=84MHz`，原 `f_sw≈400kHz`（固件按 `L=10µH` 选频）→ `arr+1≈210` → **1 码 ≈ 76mV**。
- CV 死区仅 `±5mV`，76mV 的周期性抖动被反馈环识别为误差 → 环路在死区边缘反复修正占空比 → **低频极限环（方波）**。

### 1.3 修复
`smu_ctrl_pick_arr`（`smu_ctrl.c`）与 `smu_board.h`：
- `L`：`10e-6f` → **`300e-6f`**（匹配实装电感）。
- `SMU_DI_RIPPLE_MAX`：`0.4f` → **`0.55f`**（与 300µH 配合使 `f_sw` 落到 ~20kHz 档）。
- 频率量化档：`50kHz` → **`10kHz`**（使 1 码步长随 `f_sw` 平滑，避免落入 >5mV 死区带）。
- 结果：5V 时 `f_sw≈20kHz`，`arr+1≈4200`，**1 码 ≈ 3.8mV < 5mV 死区** → 环路忽略抖动、不再掰占空比。
- 抖动保持**确定性 Σ-Δ**（伪随机版已否决，因其使读数跳动）。

> 注：伪随机抖动曾被判为"方波根因"并实装，后因"读数乱跳、方波仍在"被回退——这是本批次一次明确的方向纠错，记录在此提醒：**先看指标（读数稳定性）再定方案**。

---

## 2. 20kHz 开关纹波：硬件电容不足

### 2.1 现象
`f_sw` 降到 20kHz 后，纹波变成固定 50µs（=20kHz）宽度、正弦状：1V 输出 p-p ~70mV，12V 输出 p-p ~550mV。

### 2.2 定位
功率级输出端只有 `C118/C117` 两个 10µF/50V 陶瓷（原理图确认），直流偏压下有效容量仅 ~7µF。
- 12V：`ΔI = 12×(1−12/16)/(300µH×20kHz) = 0.5A`；`ΔV = 0.5/(8×20k×7µ) ≈ 450mV` ≈ 实测 550mV ✓
- 1V：`ΔI≈0.16A`，C 偏压轻（~15µF）→ `ΔV≈65mV` ≈ 实测 70mV ✓
- 旧 `f_sw≈400kHz` 时 `ΔV≈33mV` → 此前"高频噪声很小"，从未暴露。

### 2.3 修复（硬件）
- 实测：输出端并联 **470µF** 低 ESR 电容 → 纹波基本拉平。
- 建议长期值：**220–330µF** 即可（12V 时 `ΔV≈10–16mV`），电容更小 → 电荷更少、稳定更快、阻尼比 ζ 更好。

---

## 3. 稳定时间：软启动积分饱和回卷（3s 长尾）

### 3.1 现象
CV 模式使能：输出从 0V 冲到 ~5.5V（290ms，软启动斜坡），再花 **~3s** 从 5.5V 回落到 5V。用户确认软启动时长本身无所谓，长尾是要害。

### 3.2 定位
300ms 软启动 ramp 期间输出低于设定 → `err>0` → `s_integ += KI_CV×err` 一路攒到 `INT_MAX_CV=0.05`（≈0.8V 过量）。ramp 结束输出冲到 5.5V，积分仍 +0.05，靠 `KI_CV=0.0002` 以 `-0.0001/拍` 回卷 → 从 +0.05 回到 0 正好 ≈2–3s。

### 3.3 修复（`smu_ctrl.c` CV 分支 + `smu_board.h`）
- **软启动期间冻结 CV 积分（anti-windup）**：`if (s_softstart_ms >= SMU_SOFTSTART_MS)` 才累加积分，否则 `s_integ = 0`。ramp 结束积分=0，输出即落前馈值附近，无饱和量可回卷。
- `SMU_CTRL_KI_CV`：`0.0002f` → **`0.0006f`**（×3），残余微调更快。穿越频率仍仅 ~0.4Hz，5ms 测量延迟下相位裕度极大，不自激；dither 步长 3.8mV 仍 < 死区，方波/读数不受影响。

---

## 4. 保护硬化（smu_prot.c 等，前序会话）

- 新增状态位 `SMU_ST_PROT_ARMED`（smu_types.h）：**软启动/输出建立完成前不武装 OVP/OCP**，避免使能瞬间电压/电流尖峰误锁存（此前需每次 `*CLS`）。
- `SMU_ProtCheck` 增加**连续 20 拍（≈80ms）超限才锁存**的去抖逻辑，屏蔽尖峰。
- **移除"原始 ADC 码超饱和即锁 OCP"**：buck 开关纹波使 INA 输出瞬时削顶，原始码瞬间超 `SMU_ADC_SAT_CODE` 会误触发 OCP 把输出钉 0V；现改由滤波后 `imeas>iprot` 承担（真短路/过流均值同样超阈值，不漏保）。
- 模式提交（smu_mode.c）调用新增的 `SMU_CtrlReset()`（smu_ctrl.h 声明）清积分/抖动/软启动，避免旧状态带入新工作点。

---

## 5. 测量时序收紧（smu_meas.c，前序会话）

`ADS1115_ConvertOnce` 由固定 `vTaskDelay(2ms+1ms)` 改为**紧轮询 OS 位**等转换完成（单次 860SPS≈1.2ms），单通道转换从 ~5ms 降到 ~1.5ms，CV 环相位裕度提升（此前 ~5ms 延迟是极限环诱因之一）。

---

## 6. 验证状态（截至 2026-10-29）

- ✅ 低频方波：消失（确定性抖动 + 步长入死区）。
- ✅ 万用表有效值：0.01–12V 全范围稳定。
- ✅ 开关纹波：补输出电容后 ~7–15mV（原 550mV）。
- ✅ 稳定时间：软启动后峰值基本不冲高（≤~5.1V），5.5V→5V 回落缩至百毫秒级。
- ✅ 保护：软启动期间不误锁存；真过流/过压仍由均值判定。
- ⏳ 未在 220/330µF 长期值下复测（当前用 470µF 验证）。

---

## 7. 下一阶段建议（M2 收尾 → M4/M5）

当前固件已具备稳定的 CV/CC 闭环、低纹波、快建立、硬化保护，建议下一阶段聚焦：

1. **系统验收（AC 项）**：按 PRD §11 逐项核对 CV/CC 精度、OVP/OCP 触发点与恢复、`MEAS:ALL?`/`STAT?` 一致性。
2. **标定流程实测**：用外部标准源表验证 `CAL:VOLT:ZERO`/`CAL:VOLT:GAIN` 两点标定，固化增益/零点。
3. **Web 界面联调（M4）**：`/data.json` 实时接口 + 单页应用（设置/实时值/曲线）接线联调，确认 300ms 轮询与曲线缓冲。
4. **交付文档（M5）**：补《固件设计说明》《标定操作指南》，统一 `version.h` 版本号并封板。
5. **输出电容 BOM 化**：将 220–330µF 输出电容定为 BOM 变更（替代当前临时外焊 470µF）。
