zhutao198/SMU/hardware/Source-measure unit -V1-240824.pdf

D

6 | 5 | 4 | 3 | 2 | 1

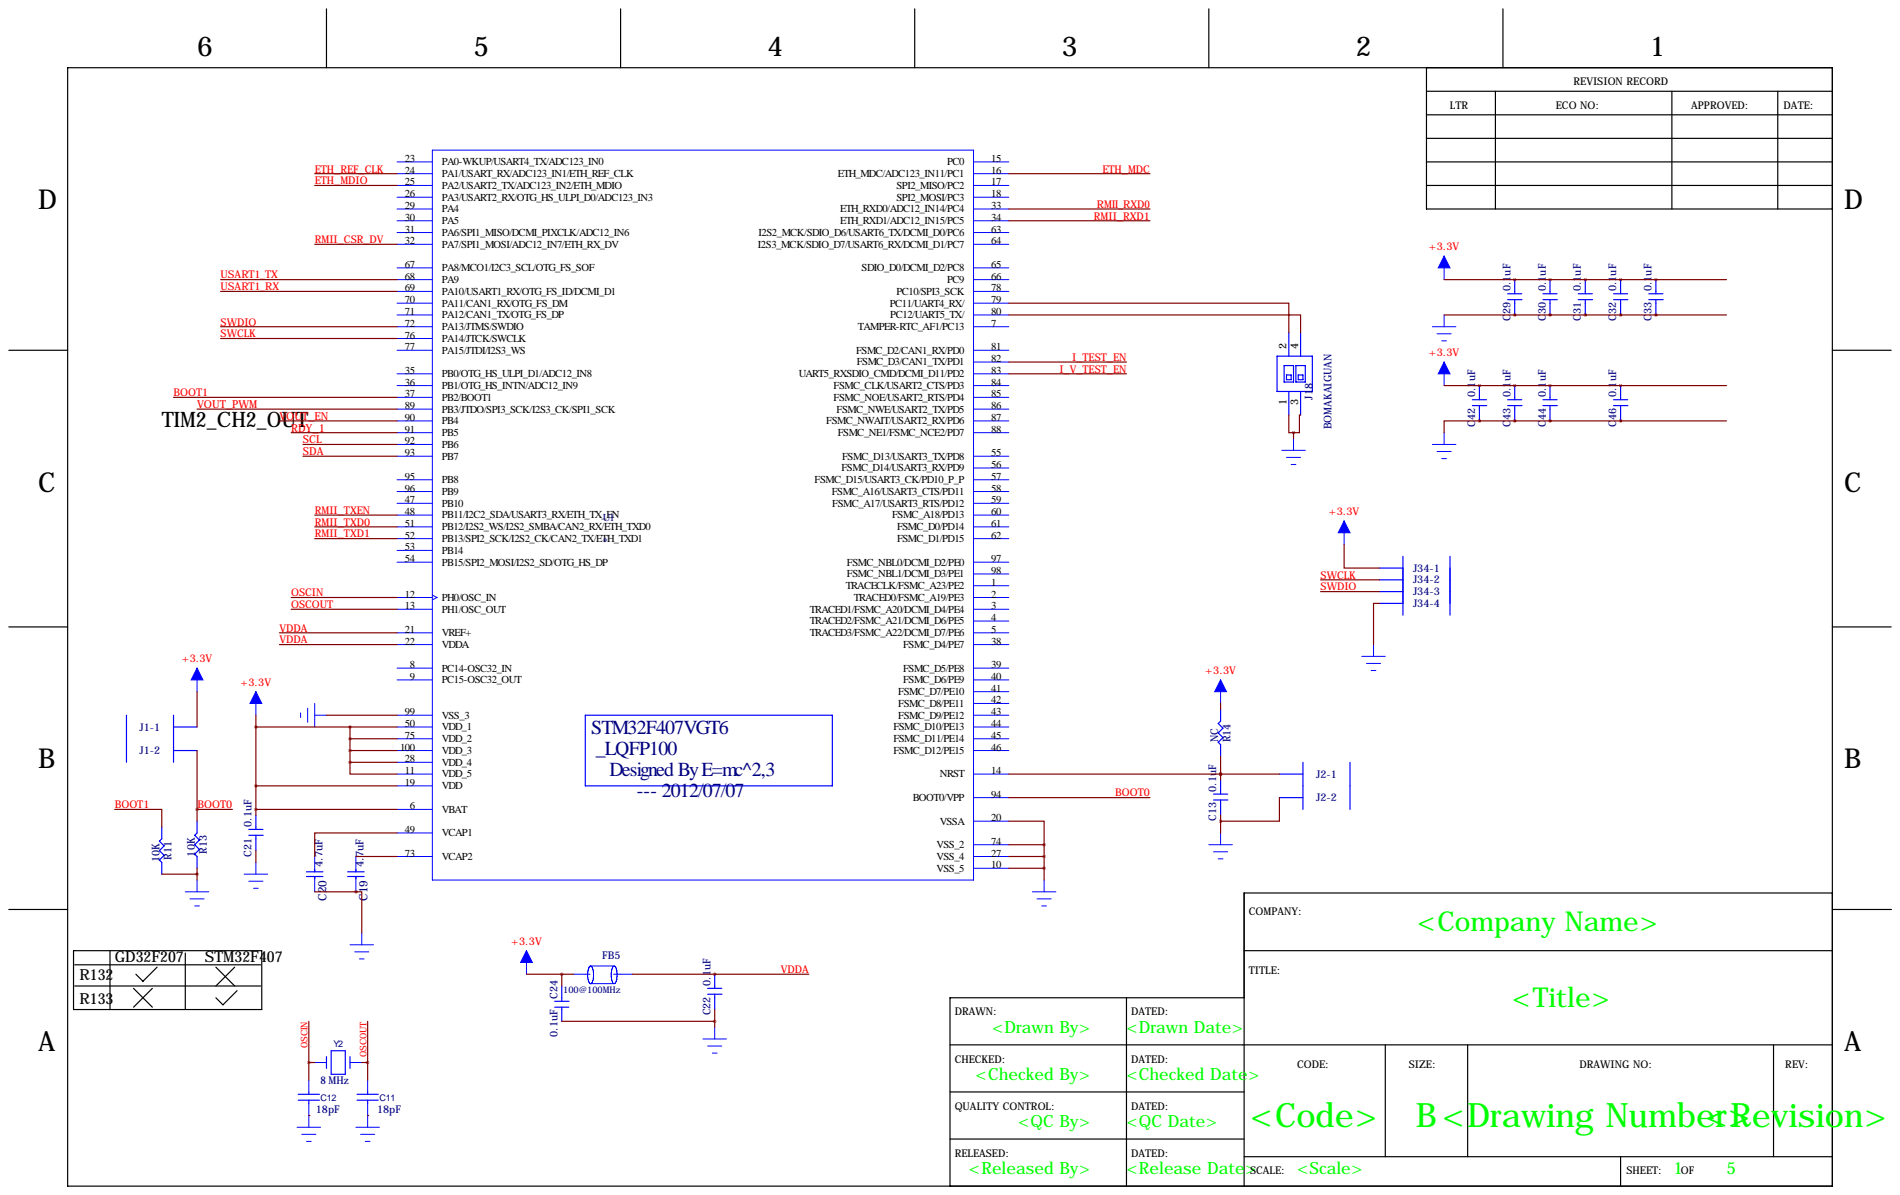
[picture p1: page 1]

REVISION RECORD

LTR | ECO NO: | APPROVED: | DATE:

R132
R133

DRAWN: <Drawn By> | DATED: <Drawn Date>

CHECKED: <Checked By> | DATED: <Checked Date> | CODE: | SIZE: | DRAWING NO: | REV:

QUALITY CONTROL: <QC By> | DATED: <QC Date>

RELEASED: <Released By> | DATED:

<Scale> SCALE: | 1 5 SHEET: OF

D

D

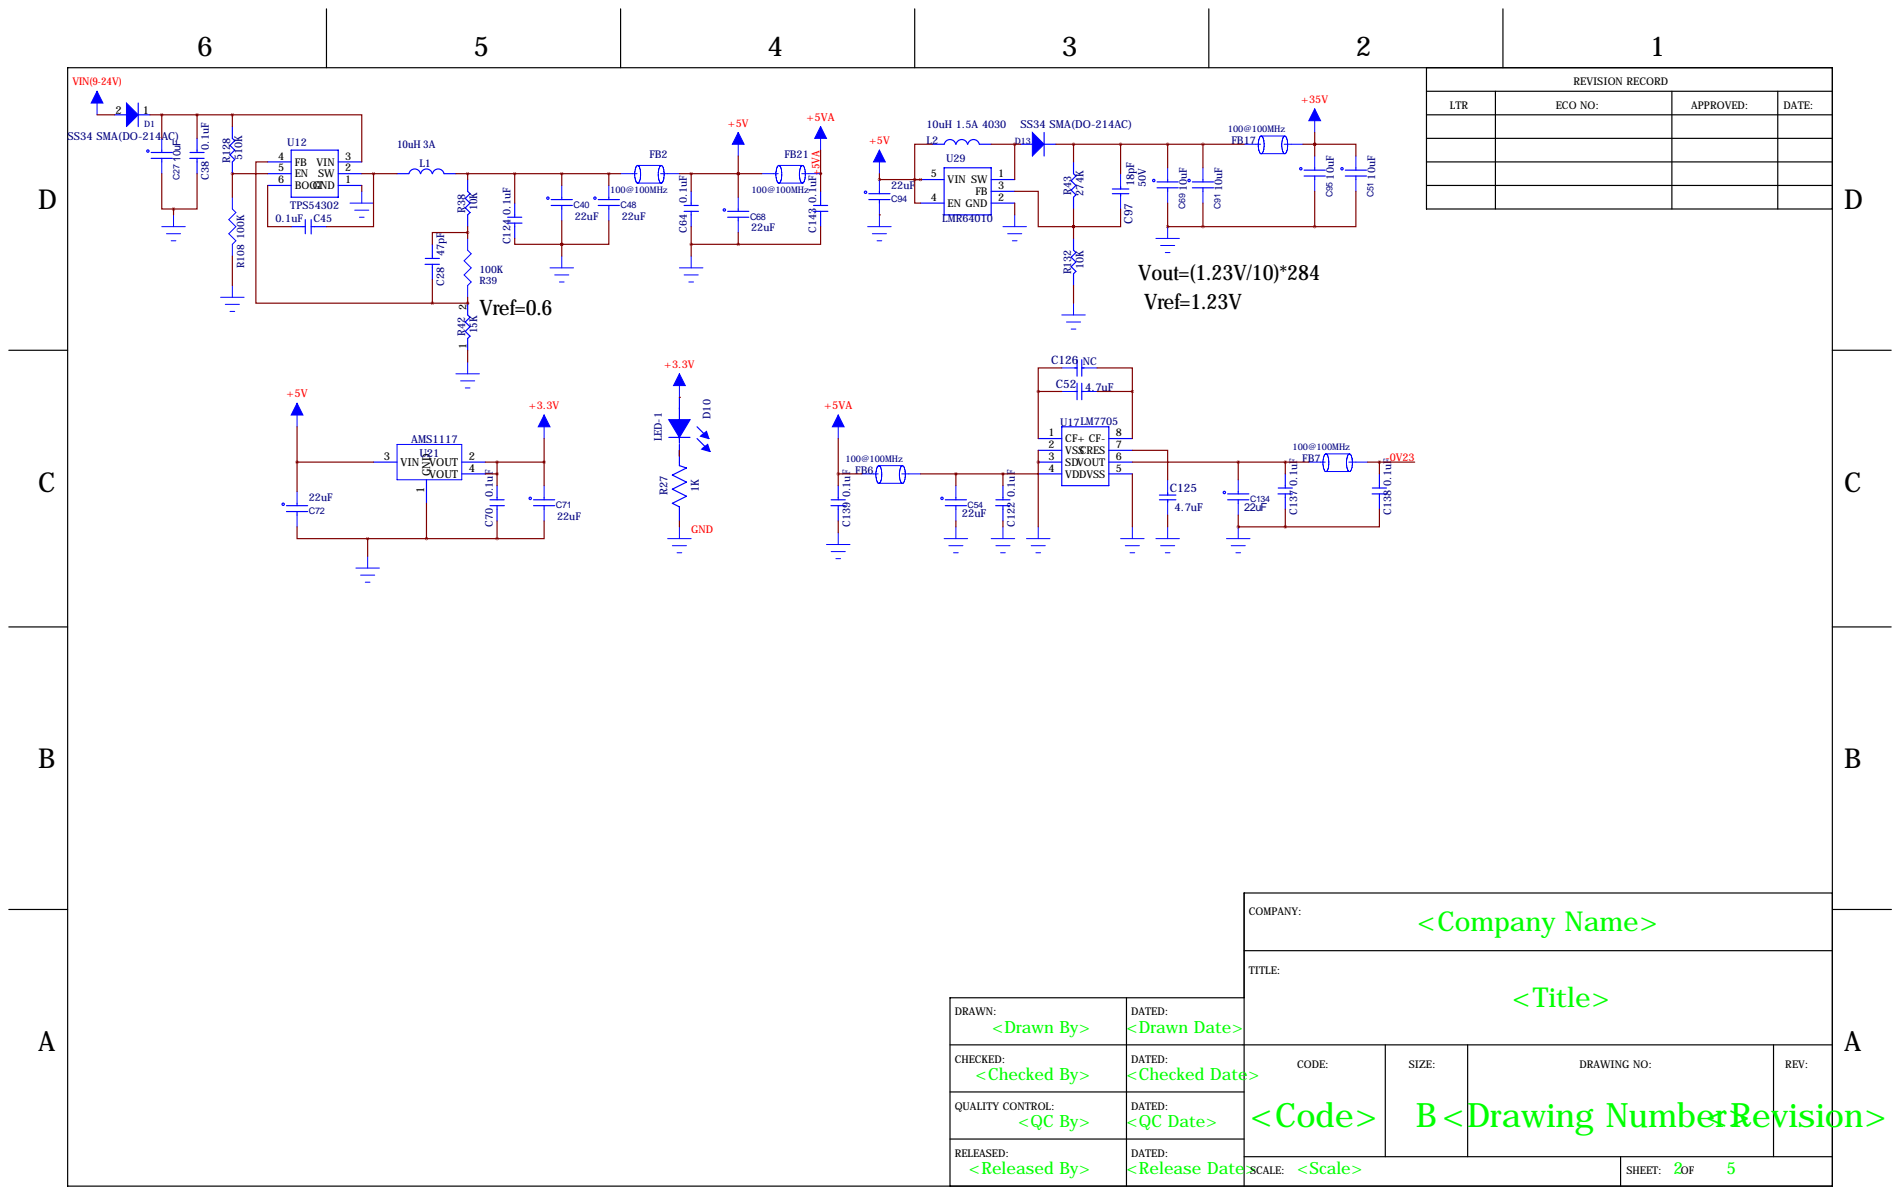
[picture p2: page 2]

REVISION RECORD

LTR | ECO NO: | APPROVED: | DATE:

FB 5 | 2
EN 6

DRAWN: <Drawn By> | DATED: <Drawn Date>

CHECKED: <Checked By> | DATED: <Checked Date> | CODE: | SIZE: | DRAWING NO: | REV:

QUALITY CONTROL: <QC By> | DATED: <QC Date>

D

D

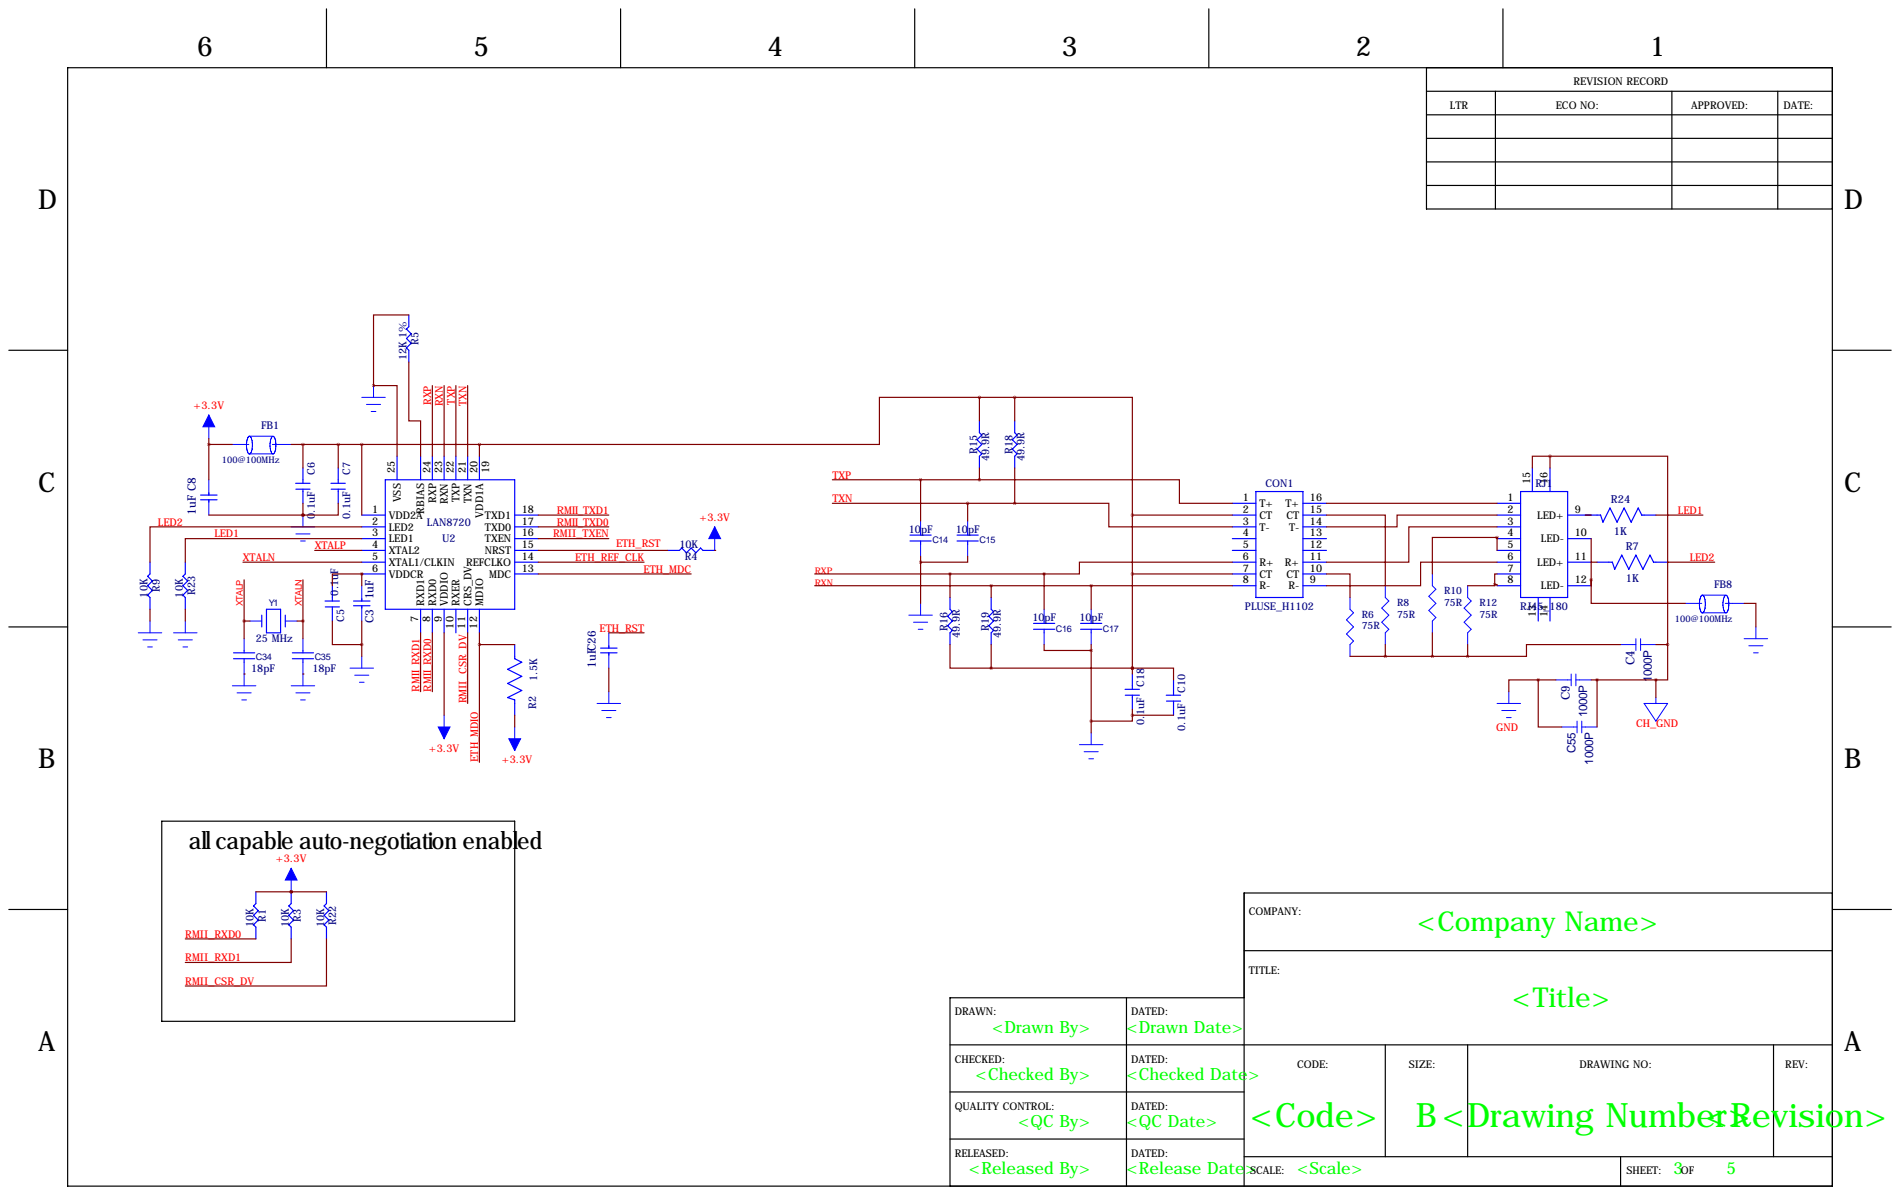
[picture p3: page 3]

REVISION RECORD

LTR | ECO NO: | APPROVED: | DATE:

18 TXD1 ¹⁹ VDD¹A ²0 TXN ²¹ TXP 22 RXN ²³ RXP 24 RBIAS

all capable auto-negotiation enabled

DRAWN: <Drawn By> | DATED: <Drawn Date>

CHECKED: <Checked By> | DATED: <Checked Date> | CODE: | SIZE: | DRAWING NO: | REV:

QUALITY CONTROL: <QC By> | DATED: <QC Date>

D

D

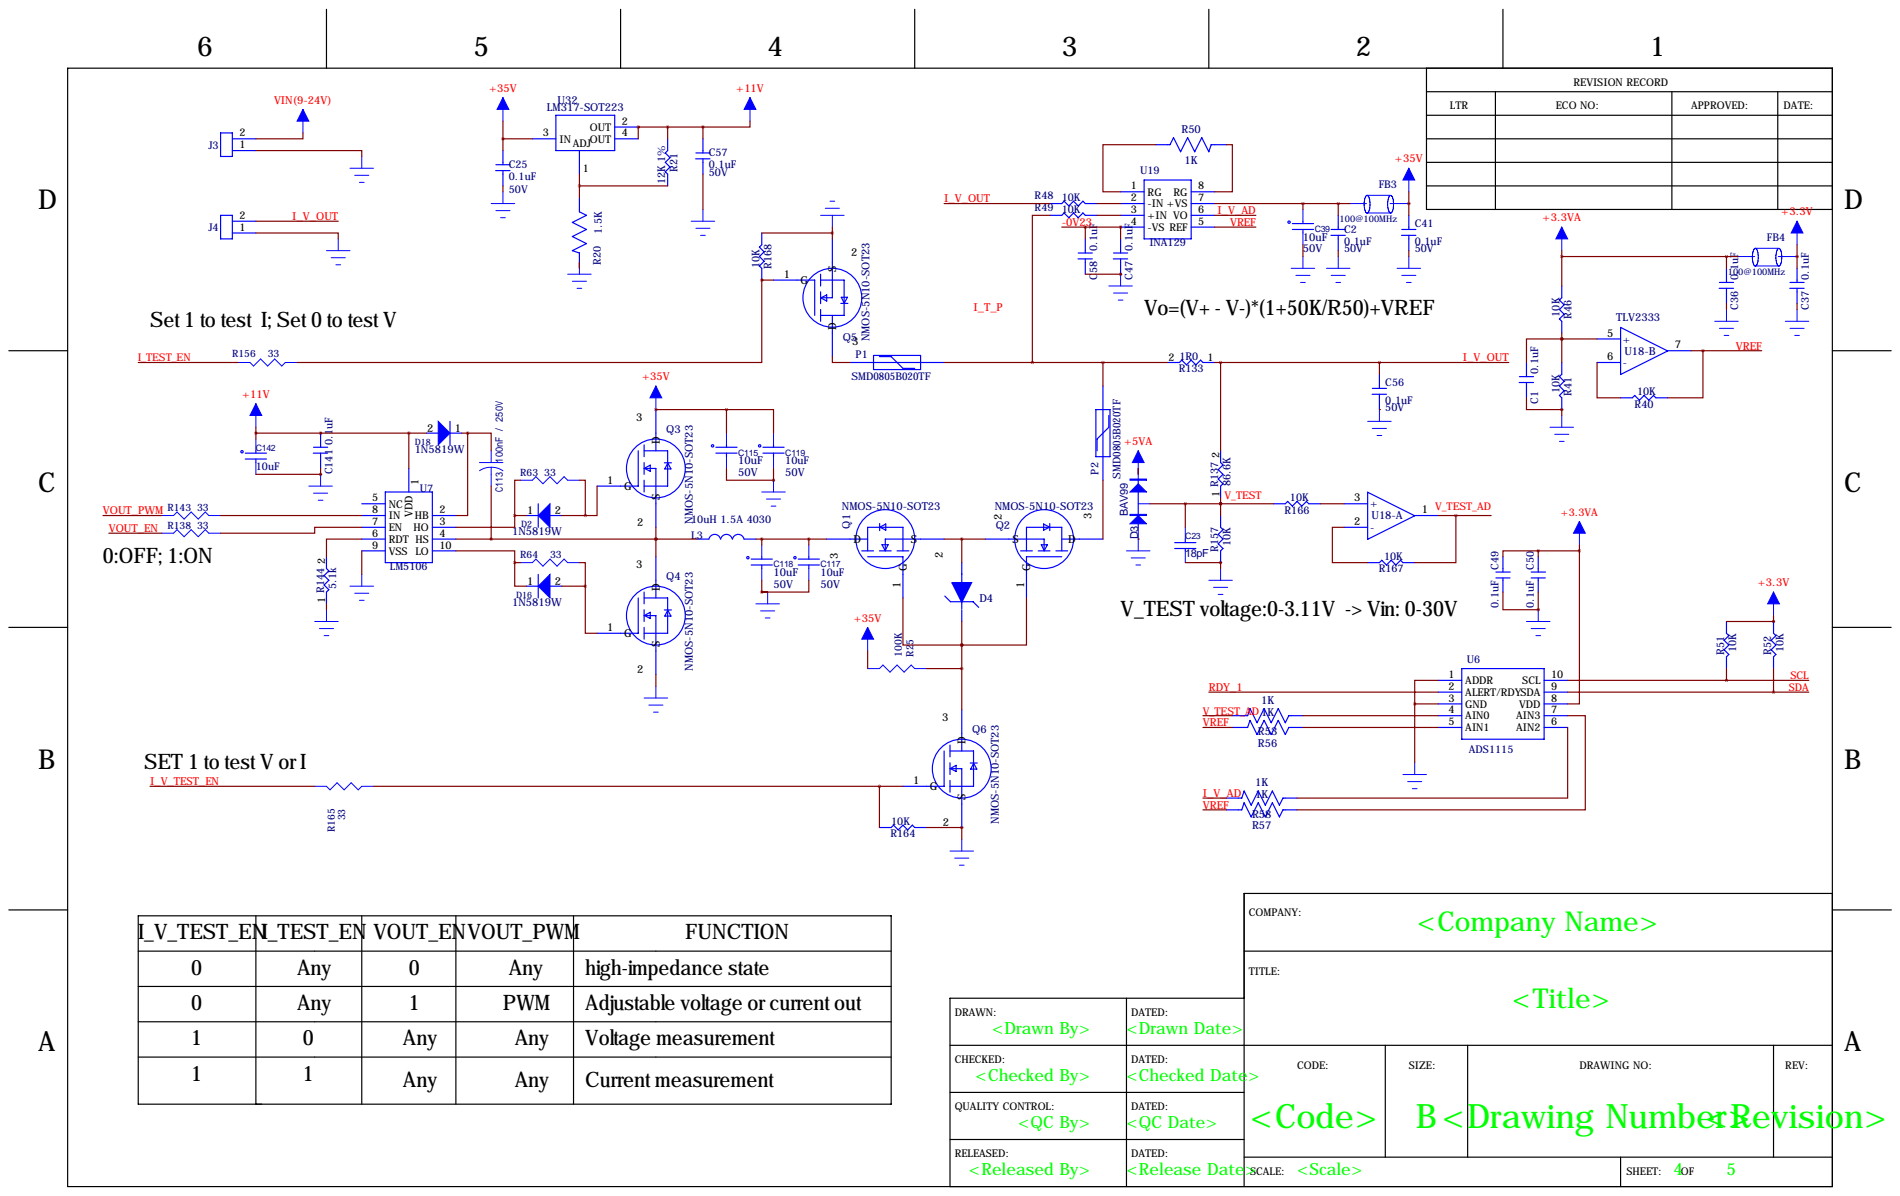
[picture p4: page 4]

+35V +11V | REVISION RECORD

LTR | ECO NO: | APPROVED: | DATE:

Set 1 to test I; Set 0 to test V

SET 1 to test V or I

0 Any | 1 | PWM | Adjustable voltage or current out
1 0 | Any | Any | Voltage measurement

DRAWN: <Drawn By> | DATED: <Drawn Date>

1 1 | Any | Any | Current measurement

CHECKED: <Checked By> | DATED: <Checked Date> | CODE: | SIZE: | DRAWING NO: | REV:

QUALITY CONTROL: <QC By> | DATED: <QC Date>

RELEASED: | DATED:

<Scale> | 4 5

D

D

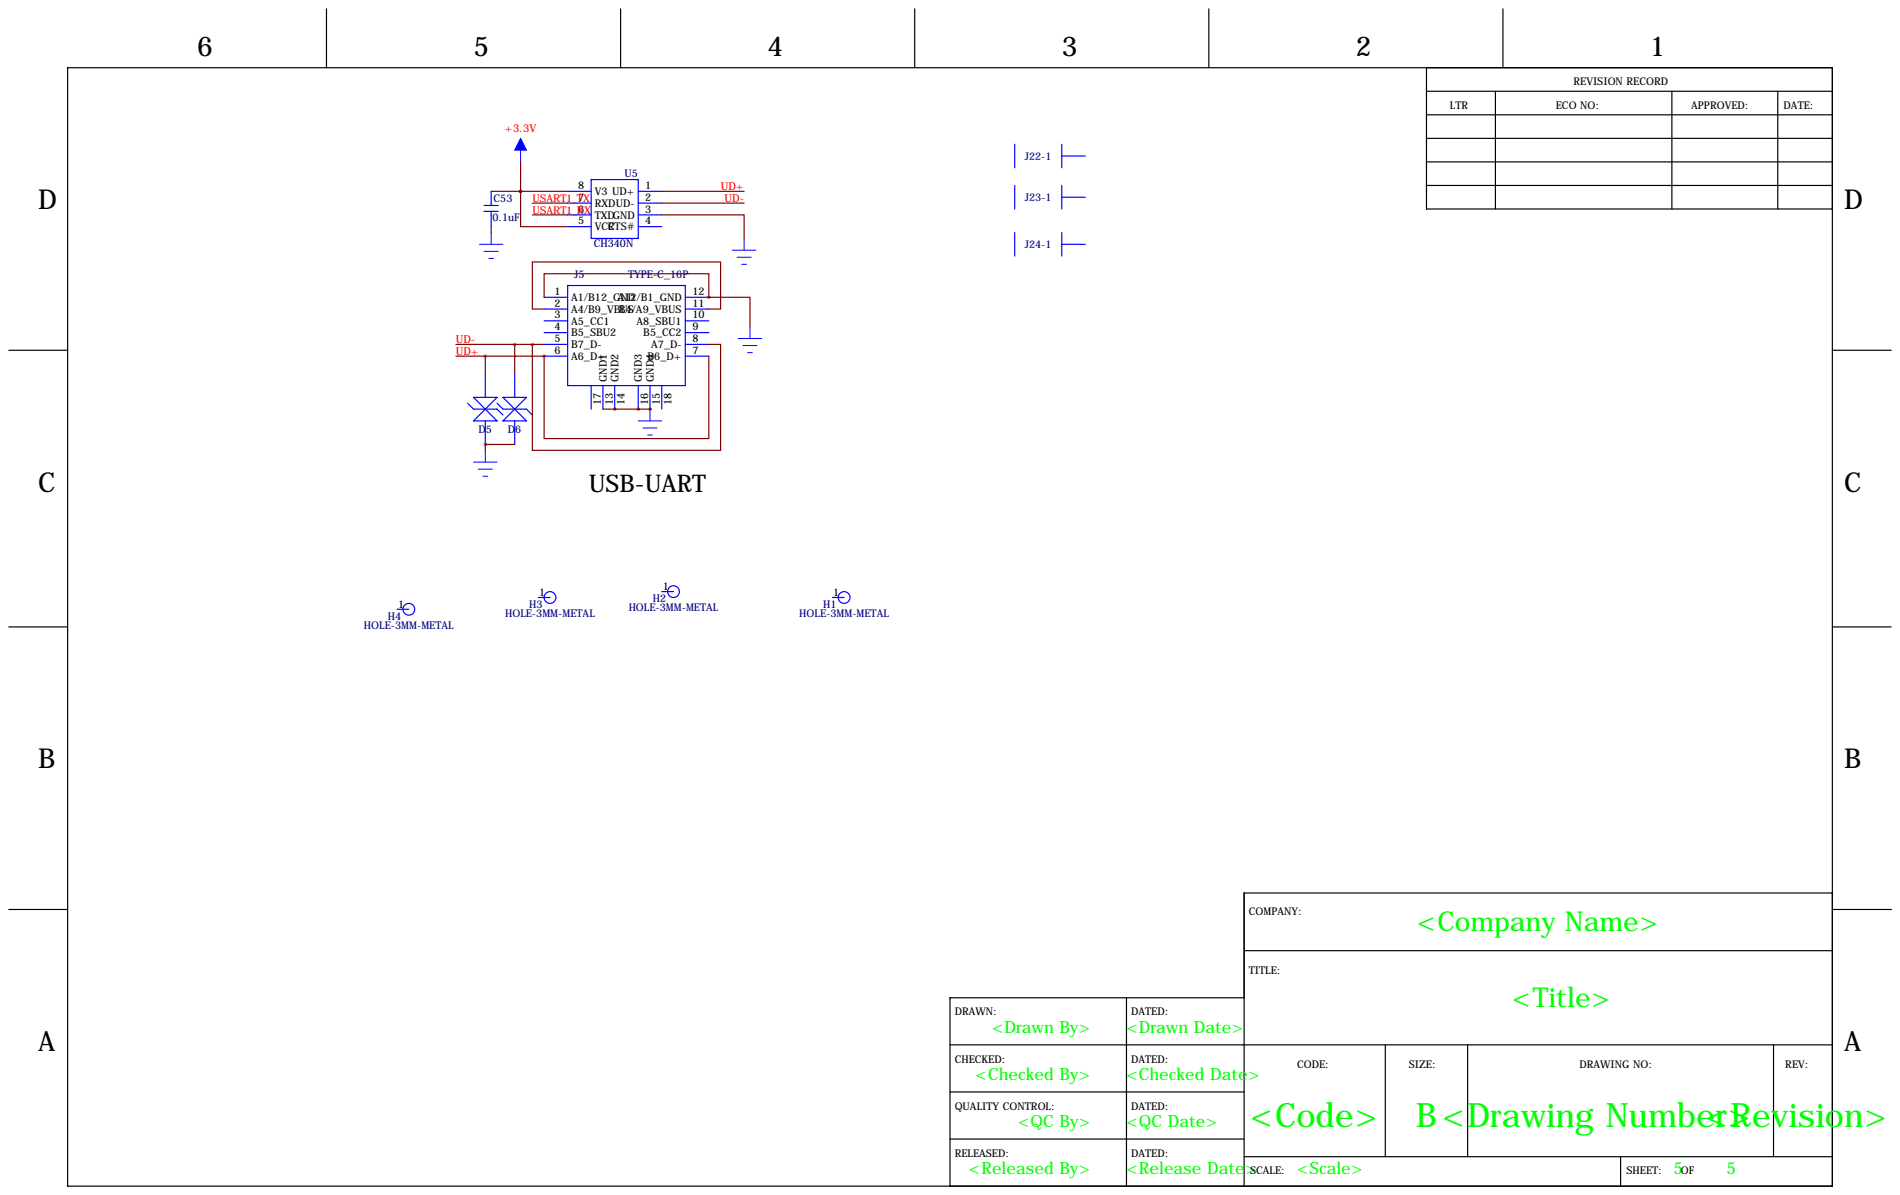
[picture p5: page 5]
<Company Name>; <Title>; <Code>; B <Drawing Number><Revision>; <Scale>; COMPANY:; TITLE:; USB-UART; 1 H1 HOLE-3MM-METAL; 1 H2 HOLE-3MM-METAL; 1 H3 HOLE-3MM-METAL; 1 H4 HOLE-3MM-METAL; GND; RTS# 5 VCC; TXD; RXD; 1 A1/B12_GND 2 A4/B9_VBUS 3 A5_CC1 4 B5_SBU2 5 B7_D- 6; 10 A8_SBU1; 11 B4/A9_VBUS; 12 A12/B1_GND; 13 GND1; 14 GND2; 16 GND3 15 GND4; TYPE-C_16P; USART1_RX; USART1_TX

+3.3V | REVISION RECORD

LTR | ECO NO: | APPROVED: | DATE:

DRAWN: <Drawn By> | DATED: <Drawn Date>

CHECKED: <Checked By> | DATED: <Checked Date> | CODE: | SIZE: | DRAWING NO: | REV:

QUALITY CONTROL: <QC By> | DATED: <QC Date>
