zhutao198/SMU/(list of files, drawings)

Other design files:
hardware/Source-measure unit -V1-240824.pcb
