zhutao198/SMU/code/firmware/Core/Inc/smu_webpage.h

/**
 * @file   smu_webpage.h
 * @brief  自动生成，请勿手改！源: index.html (24320 bytes)
 * @note   由 tools/web2c.py 生成（PRD NFR-8）
 */
#ifndef SMU_WEBPAGE_H
#define SMU_WEBPAGE_H

#include <stdint.h>

#define SMU_WEBPAGE_LEN 24320U

static const uint8_t smu_webpage[] = {
  0x3C,0x21,0x44,0x4F,0x43,0x54,0x59,0x50,0x45,0x20,0x68,0x74,0x6D,0x6C,0x3E,0x0D,
  0x0A,0x3C,0x68,0x74,0x6D,0x6C,0x20,0x6C,0x61,0x6E,0x67,0x3D,0x22,0x7A,0x68,0x2D,
  0x43,0x4E,0x22,0x3E,0x0D,0x0A,0x3C,0x68,0x65,0x61,0x64,0x3E,0x0D,0x0A,0x3C,0x6D,
  0x65,0x74,0x61,0x20,0x63,0x68,0x61,0x72,0x73,0x65,0x74,0x3D,0x22,0x55,0x54,0x46,
  0x2D,0x38,0x22,0x3E,0x0D,0x0A,0x3C,0x6D,0x65,0x74,0x61,0x20,0x6E,0x61,0x6D,0x65,
  0x3D,0x22,0x76,0x69,0x65,0x77,0x70,0x6F,0x72,0x74,0x22,0x20,0x63,0x6F,0x6E,0x74,
  0x65,0x6E,0x74,0x3D,0x22,0x77,0x69,0x64,0x74,0x68,0x3D,0x64,0x65,0x76,0x69,0x63,
  0x65,0x2D,0x77,0x69,0x64,0x74,0x68,0x2C,0x20,0x69,0x6E,0x69,0x74,0x69,0x61,0x6C,
  0x2D,0x73,0x63,0x61,0x6C,0x65,0x3D,0x31,0x22,0x3E,0x0D,0x0A,0x3C,0x74,0x69,0x74,
  0x6C,0x65,0x3E,0x53,0x4D,0x55,0x20,0xE6,0xBA,0x90,0xE8,0xA1,0xA8,0xE6,0x8E,0xA7,
  0xE5,0x88,0xB6,0xE5,0x8F,0xB0,0x3C,0x2F,0x74,0x69,0x74,0x6C,0x65,0x3E,0x0D,0x0A,
  0x3C,0x73,0x74,0x79,0x6C,0x65,0x3E,0x0D,0x0A,0x3A,0x72,0x6F,0x6F,0x74,0x7B,0x0D,
  0x0A,0x20,0x20,0x2D,0x2D,0x62,0x67,0x3A,0x23,0x30,0x64,0x31,0x31,0x31,0x37,0x3B,
  0x20,0x2D,0x2D,0x63,0x61,0x72,0x64,0x3A,0x23,0x31,0x36,0x31,0x62,0x32,0x32,0x3B,
  0x20,0x2D,0x2D,0x63,0x61,0x72,0x64,0x32,0x3A,0x23,0x31,0x63,0x32,0x33,0x33,0x30,
  0x3B,0x20,0x2D,0x2D,0x62,0x64,0x3A,0x23,0x32,0x62,0x33,0x34,0x34,0x30,0x3B,0x20,
  0x2D,0x2D,0x62,0x64,0x32,0x3A,0x23,0x33,0x61,0x34,0x36,0x35,0x35,0x3B,0x0D,0x0A,
  0x20,0x20,0x2D,0x2D,0x74,0x78,0x3A,0x23,0x65,0x36,0x65,0x64,0x66,0x33,0x3B,0x20,
  0x2D,0x2D,0x6D,0x75,0x3A,0x23,0x38,0x62,0x39,0x38,0x61,0x35,0x3B,0x20,0x2D,0x2D,
  0x61,0x63,0x63,0x3A,0x23,0x34,0x64,0x61,0x33,0x66,0x66,0x3B,0x20,0x2D,0x2D,0x67,
  0x72,0x6E,0x3A,0x23,0x33,0x66,0x62,0x39,0x35,0x30,0x3B,0x20,0x2D,0x2D,0x61,0x6D,
  0x62,0x3A,0x23,0x64,0x32,0x39,0x39,0x32,0x32,0x3B,0x20,0x2D,0x2D,0x72,0x65,0x64,
  0x3A,0x23,0x66,0x38,0x35,0x31,0x34,0x39,0x3B,0x20,0x2D,0x2D,0x70,0x75,0x72,0x3A,
  0x23,0x62,0x63,0x38,0x63,0x66,0x66,0x3B,0x0D,0x0A,0x20,0x20,0x2D,0x2D,0x6D,0x6F,
  0x6E,0x6F,0x3A,0x22,0x53,0x46,0x20,0x4D,0x6F,0x6E,0x6F,0x22,0x2C,0x43,0x6F,0x6E,
  0x73,0x6F,0x6C,0x61,0x73,0x2C,0x22,0x52,0x6F,0x62,0x6F,0x74,0x6F,0x20,0x4D,0x6F,
  0x6E,0x6F,0x22,0x2C,0x22,0x4C,0x69,0x62,0x65,0x72,0x61,0x74,0x69,0x6F,0x6E,0x20,
  0x4D,0x6F,0x6E,0x6F,0x22,0x2C,0x6D,0x6F,0x6E,0x6F,0x73,0x70,0x61,0x63,0x65,0x3B,
  0x0D,0x0A,0x7D,0x0D,0x0A,0x2A,0x7B,0x62,0x6F,0x78,0x2D,0x73,0x69,0x7A,0x69,0x6E,
  0x67,0x3A,0x62,0x6F,0x72,0x64,0x65,0x72,0x2D,0x62,0x6F,0x78,0x3B,0x6D,0x61,0x72,
  0x67,0x69,0x6E,0x3A,0x30,0x3B,0x70,0x61,0x64,0x64,0x69,0x6E,0x67,0x3A,0x30,0x7D,
  0x0D,0x0A,0x62,0x6F,0x64,0x79,0x7B,0x62,0x61,0x63,0x6B,0x67,0x72,0x6F,0x75,0x6E,
  0x64,0x3A,0x76,0x61,0x72,0x28,0x2D,0x2D,0x62,0x67,0x29,0x3B,0x63,0x6F,0x6C,0x6F,
  0x72,0x3A,0x76,0x61,0x72,0x28,0x2D,0x2D,0x74,0x78,0x29,0x3B,0x66,0x6F,0x6E,0x74,
  0x3A,0x31,0x34,0x70,0x78,0x2F,0x31,0x2E,0x35,0x20,0x2D,0x61,0x70,0x70,0x6C,0x65,
  0x2D,0x73,0x79,0x73,0x74,0x65,0x6D,0x2C,0x22,0x53,0x65,0x67,0x6F,0x65,0x20,0x55,
  0x49,0x22,0x2C,0x52,0x6F,0x62,0x6F,0x74,0x6F,0x2C,0x22,0x50,0x69,0x6E,0x67,0x46,
  0x61,0x6E,0x67,0x20,0x53,0x43,0x22,0x2C,0x22,0x4D,0x69,0x63,0x72,0x6F,0x73,0x6F,
  0x66,0x74,0x20,0x59,0x61,0x48,0x65,0x69,0x22,0x2C,0x73,0x61,0x6E,0x73,0x2D,0x73,
  0x65,0x72,0x69,0x66,0x3B,0x6D,0x69,0x6E,0x2D,0x68,0x65,0x69,0x67,0x68,0x74,0x3A,
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
};

#endif /* SMU_WEBPAGE_H */
