zhutao198/SMU/code/firmware/Core/Inc/smu_ver.h

/**
 * @file   smu_ver.h
 * @brief  固件版本号（NFR-6：统一在 version.h）
 */
#ifndef SMU_VER_H
#define SMU_VER_H

#define SMU_FW_NAME        "SMU-V1"
#define SMU_FW_VERSION     "0.1.0"      /* M1 里程碑版本 */
#define SMU_FW_BUILD       __DATE__ " " __TIME__

#endif /* SMU_VER_H */
