zhutao198/SMU/code/firmware/tools/verify/usart1.c

/**
 * @file   usart1.c
 * @brief  MX_USART1_UART_Init：115200-8N1（CH340N，FR-COMM-1）
 */
#include "main.h"

UART_HandleTypeDef huart1;

void MX_USART1_UART_Init(void)
{
  huart1.Instance = USART1;
  huart1.Init.BaudRate = 115200;
  huart1.Init.WordLength = UART_WORDLENGTH_8B;
  huart1.Init.StopBits = UART_STOPBITS_1;
  huart1.Init.Parity = UART_PARITY_NONE;
  huart1.Init.Mode = UART_MODE_TX_RX;
  huart1.Init.HwFlowCtl = UART_HWCONTROL_NONE;
  huart1.Init.OverSampling = UART_OVERSAMPLING_16;
  if (HAL_UART_Init(&huart1) != HAL_OK) Error_Handler();
}

void HAL_UART_MspInit(UART_HandleTypeDef *huart)
{
  GPIO_InitTypeDef g = {0};
  if (huart->Instance != USART1) return;
  __HAL_RCC_USART1_CLK_ENABLE();
  __HAL_RCC_GPIOA_CLK_ENABLE();
  g.Pin = GPIO_PIN_9 | GPIO_PIN_10;
  g.Mode = GPIO_MODE_AF_PP;
  g.Pull = GPIO_PULLUP;
  g.Speed = GPIO_SPEED_FREQ_HIGH;
  g.Alternate = GPIO_AF7_USART1;
  HAL_GPIO_Init(GPIOA, &g);

  /* 中断优先级必须 < configMAX_SYSCALL_INTERRUPT_PRIORITY(5)：
   * FreeRTOS 临界区用 BASEPRI=0x50 屏蔽优先级 >=5 的中断，
   * USART1 若设为 5/6 会被 BASEPRI 挡住（RXNE 一直挂起、数据无人读走）。
   * 本中断不调用任何 FreeRTOS API（只写环形缓冲），用高优先级安全。 */
  HAL_NVIC_SetPriority(USART1_IRQn, 4, 0);
  HAL_NVIC_EnableIRQ(USART1_IRQn);
}
