zhutao198/SMU/(commit log)

2026-10-27 SMU M1+M2 进展：RTOS框架、ADS1115测量链、CC/CV闭环、两点标定、Flash双备份 -- 修复 ADS1115 测量链串味(单所有者架构) 与 CAL:SAVE 扇区越界(F407VE 512KB) -- UART接收提前装填,消除首条命令-100 -- CV/CC闭环、两点标定、OVP/OCP框架、Web服务、NV乒乓备份 -- IWDG 诊断期临时禁用(SMU_IWDG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
    [BOM-SMU-V1-240904.xls, Source-measure unit -V1-240824.pcb, Source-measure unit -V1-240824.sch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]
2026-10-28 修复 OUTP OFF 浮空漏电(输出钳0V)；控制环一阶Σ-Δ抖动；自适应开关频率
    - OUTP OFF/HIZ：保持低边管导通(EN=1,duty=0)把 J4 钳在 0V，消除关断时
    被功率级漏电(LM5106 自举残压/35V 经关断管漏电)抬到 ~0.56V；VM/IM 测量
    模式仍 EN=0 真高阻，避免短接被测件
    - CV/CC 控制环一阶 Σ-Δ 抖动：分数占空比分摊到相邻计数码，消除 1 码≈162mV
    台阶造成的极限环抖动(2V+ 已稳定 2.009)
    - 自适应 f_sw：低电压降频延长导通时间改善 1~2V 调节，高电压/大电流维持
    400kHz 防 10µH/1.5A 电感纹波饱和；占空比以分数表示，改频后平均占空比
    不变→输出电压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
    [smu_board.h, smu_ctrl.c, smu_mode.c]
2026-10-29 控制环与测量链调优：消除低频方波/开关纹波、缩短稳定时间、保护硬化
    【低频方波根因修复】
    - smu_ctrl_pick_arr 的输出电感由写死 10µH 改为实际 300µH；SMU_DI_RIPPLE_MAX
    0.4→0.55、频率量化档 50kHz→10kHz，使 f_sw 落到 ~20kHz 档，1 码步长 ≤~4mV
    < CV 死区 5mV，环路不再把 Σ-Δ 抖动当误差反复"掰"占空比 → 低频方波消失。
    - 抖动回退为确定性 Σ-Δ（伪随机化会使万用表有效值跳动，已否决）。
    【开关纹波（硬件）】
    - 输出端原仅 2×10µF 陶瓷（偏压下有效 ~7µF），扛不住 20kHz 开关纹波
    （12V 时 ΔI≈0.5A → 550mV p-p）。实测补 470µF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
    [smu_board.h, smu_ctrl.c, smu_ctrl.h, smu_meas.c, smu_mode.c, smu_prot.c, smu_types.h]
2026-10-31 SMU Dev: 保护范围/启动输出/网页校准与离线判定修复
    - 保护：过压默认阈值 13V->15V(与SMU_V_MAX一致,避免满程输出被OVP误锁);
    电流设定上限与过流默认由30mA->120mA(受电流检测链路满量程~120mA限制,
    保证OCP真能触发、测量不削顶;200mA需改低增益硬件+重新标定)
    - 输出：上电HIZ改为EN=1+低边接地钳0V,消除启动浮空漏电0.56V
    - 网页：data.json新增vmax/imax,前端量程动态跟随;新增校准CAL控制卡片
    (CAL:VOLT/CURR:ZERO/GAIN/SAVE/DEF);CAL:SAVE擦128KB Flash~1s卡顿改为
    连续失败才判离线,消除'未连接到仪器'误报
    - 工具：补充网络诊断(verify/)与jlink诊断脚本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
    [ethernetif.c, lan8720.c, lwip.c, lwipopts.h, smu_board.h, smu_mode.c, smu_web.c, smu_webpage.h]
2026-10-31 SMU Dev: CV积分增益提速 + 网页Y轴自适应刻度 + 说明书
    - 控制：CV 积分增益 KI_CV 0.0006->0.0018(3x)，加快残差/负载阶跃收敛，过冲仍<2%
    - 网页：drawChart 增加 Y 轴竖线+轴上刻度线/数值，量程随波形自适应整数吸附(1/2/5x10^n)
    - 工具：新增 settle_probe.py 阶跃瞬态采样脚本
    - 文档：新增 doc/SMU使用说明书.md(网页控制台与串口/HTTP命令为重点)
